moris626/rmap/arduino/doc/img/ethernet.jpg

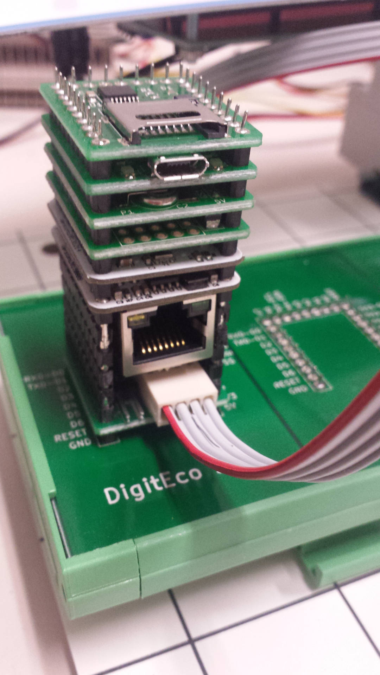
arduino/doc/img/ethernet.jpg
