moris626/rmap/arduino/doc/img/hub.jpg

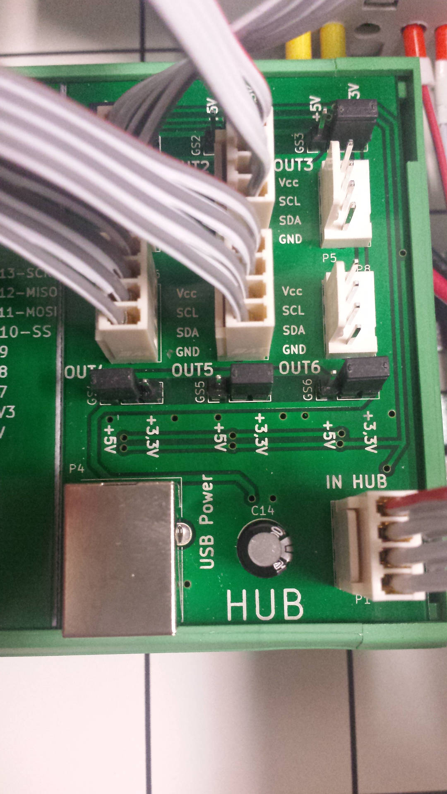
arduino/doc/img/hub.jpg
