moris626/rmap/kicad/r-map_v2/breakout_board/NO2-CO/README.md

Schematic preview
=================
