moris626/rmap/arduino/doc/img/gsm.jpg

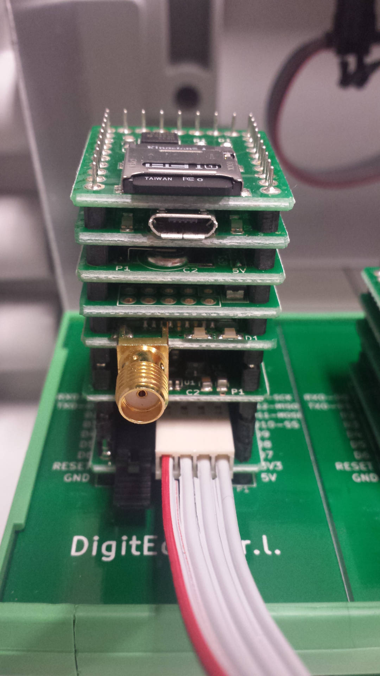
arduino/doc/img/gsm.jpg
