moris626/rmap/arduino/doc/img/passive.jpg

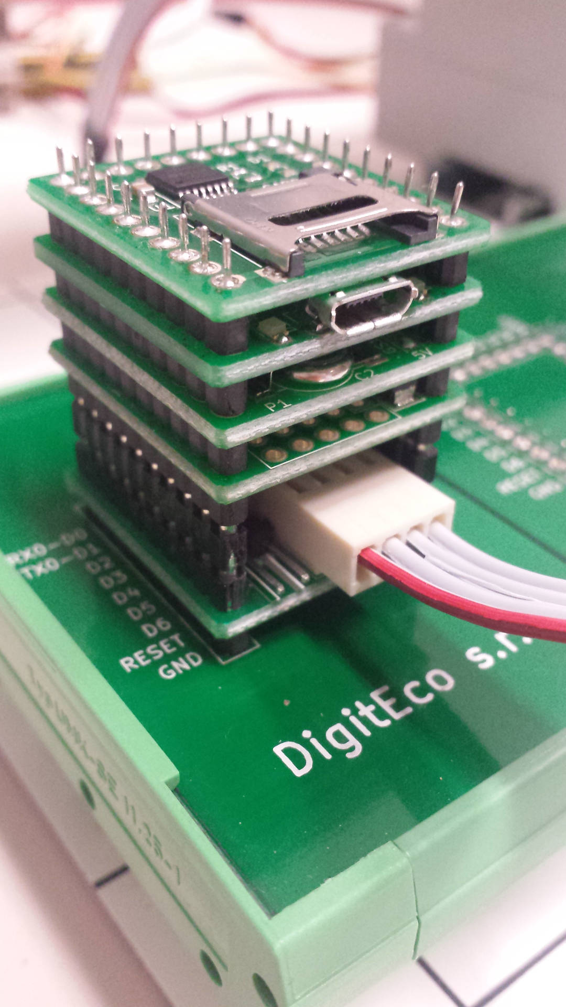
arduino/doc/img/passive.jpg
