moris626/rmap/arduino/doc/img/rain.jpg

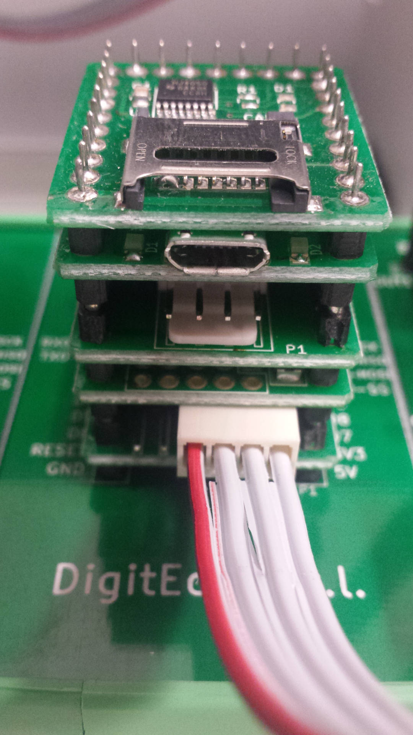
arduino/doc/img/rain.jpg
