moris626/rmap/arduino/doc/img/station.jpg

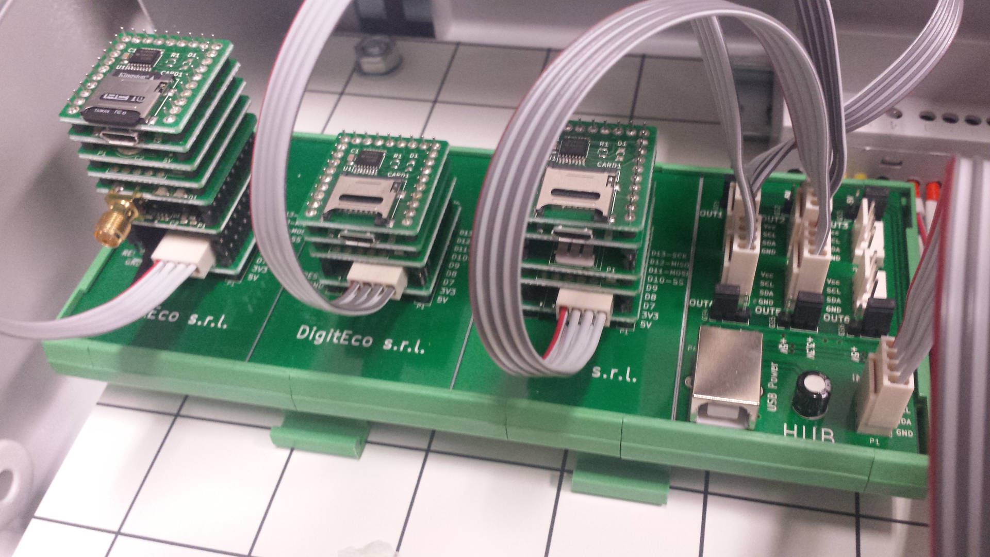
arduino/doc/img/station.jpg
