moris626/rmap/arduino/doc/img/th.jpg

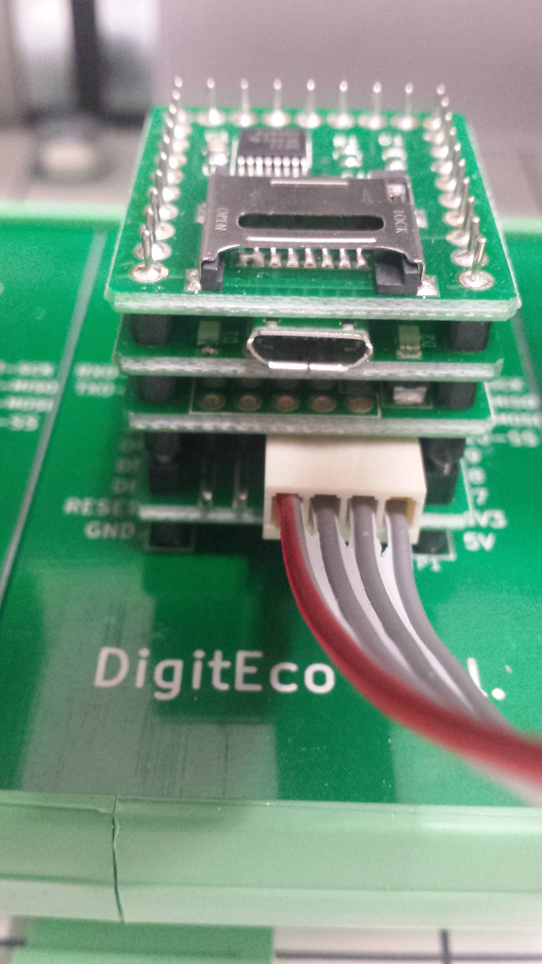
arduino/doc/img/th.jpg
