moris626/rmap/kicad/r-map_v2/Microduino_BASE_DE/Elenco_componenti_Base_DE.xls

Riferimento | Contenitore | QuantitÃ | Valore | Produttore
GS1 | GS3 | 1 | GS3
P1 | Pin_Header_Angled_1x02_Pitch2.54mm | 1 | CONN_01X02
P2 | AMPMODUII_4pin_90Â° | 1 | CONN_01X04
P3 | Upin_27 | 1 | CONN_1x27
