moris626/rmap/kicad/r-map_v2/Microduino_RTC_DE/Ordine_componenti_RTC_DE.xls

Riferimento | Contenitore | QuantitÃ | Valore | Produttore
C1 | C_0805 | 1 | 0,1 uF
C2 | Supercap | 1 | 0,2F
CV1 | C_1206 | 1 | 5-25 pF
D1 | D_MiniMELF_Standard | 1 | TMMBAT43
D2 | D_SOD-323 | 1 | MM3Z3V3ST1G
GS1,GS2,GS3 | GS3 | 3 | GS3
P1 | Strip femmina 1x27 Pitch2.54mm | 1 | CONN_01X27
R3,R1,R2 | R_0805 | 3 | 4k7
R4 | R_0805 | 1 | 33
U1 | SOIC-8_3.9x4.9mm_Pitch1.27mm | 1 | PCF8563
Y1 | Crystal_SMD_G8-2pin_3.2x1.5mm_HandSoldering | 1 | 32,762 kHz
