moris626/rmap/kicad/r-map_v2/Microduino_DIGITALE_DE/Ordine_componenti_DIGITALE_DE.xls

Riferimento | Contenitore | QuantitÃ | Valore | Produttore
P1 | Upin_27 | 1 | CONN_1x27
P2 | AMPMODUII_4pin_90Â° | 1 | CONN_01X04
