moris626/rmap/kicad/r-map_v2/Microduino_SUPPORTO_DE/Elenco_componenti_Supporto_DE.xls

Riferimento | Contenitore | QuantitÃ | Valore | Produttore
P1 | Upin_27 | 1 | CONN_1x27
