moris626/rmap/arduino/sketchbook/stima_v2/rmap_esp8266/HOWTO_en.md

With this firmware is possible to publish data on an RMAP server.
Short instructions:

    register on RMAP to get username and password:
    http://rmap.cc/registrazione/register/

    Make a new station on server:
    http://rmapv.rmap.cc/insertdata/newstation
    insert your address or use "draw a marker" instrument on map and insert the station name.
    Select "luftdaten" as station model type

Follow the standard procedure as for luftdaten.info for hardware hassembly.
http://luftdaten.info
but in the configuration page insert RMAP specifications:

    username
    password
    station name

Save and all is done.
