moris626/rmap/arduino/sketchbook/stima_v2/rmap_esp8266/HOWTO_it.md

Con questo firmware è possibile pubblicare i dati su un server RMAP.
Istruzioni in breve:

    registratevi sul server RMAP per ottenere username e password:
    http://rmap.cc/registrazione/register/

    Create una nuova stazione sul server:
    http://rmapv.rmap.cc/insertdata/newstation
    inserite il vostro indirizzo o utilizzate lo strumento "draw a marker" sulla mappa e inserite il nome della stazione.
    Selezionate "luftdaten" come modello della stazione

Seguite le istruzioni per assemblare l'hardware come descritto su luftdaten.info
http://luftdaten.info/it/traduzione-delle-istruzioni-per-il-montaggio-del-sensore-di-polveri-sottili/
ma nella pagina di configurazione inserite i dati per RMAP:

    username
    password
    nome stazione

Salvate e tutto è completato.
