moris626/rmap/kicad/stima_v3/Microduino_SD_DE/Microduino_SD_DE.kicad_pcb

## KiCad design kicad/stima_v3/Microduino_SD_DE/Microduino_SD_DE.kicad_pcb (2018-06-27)

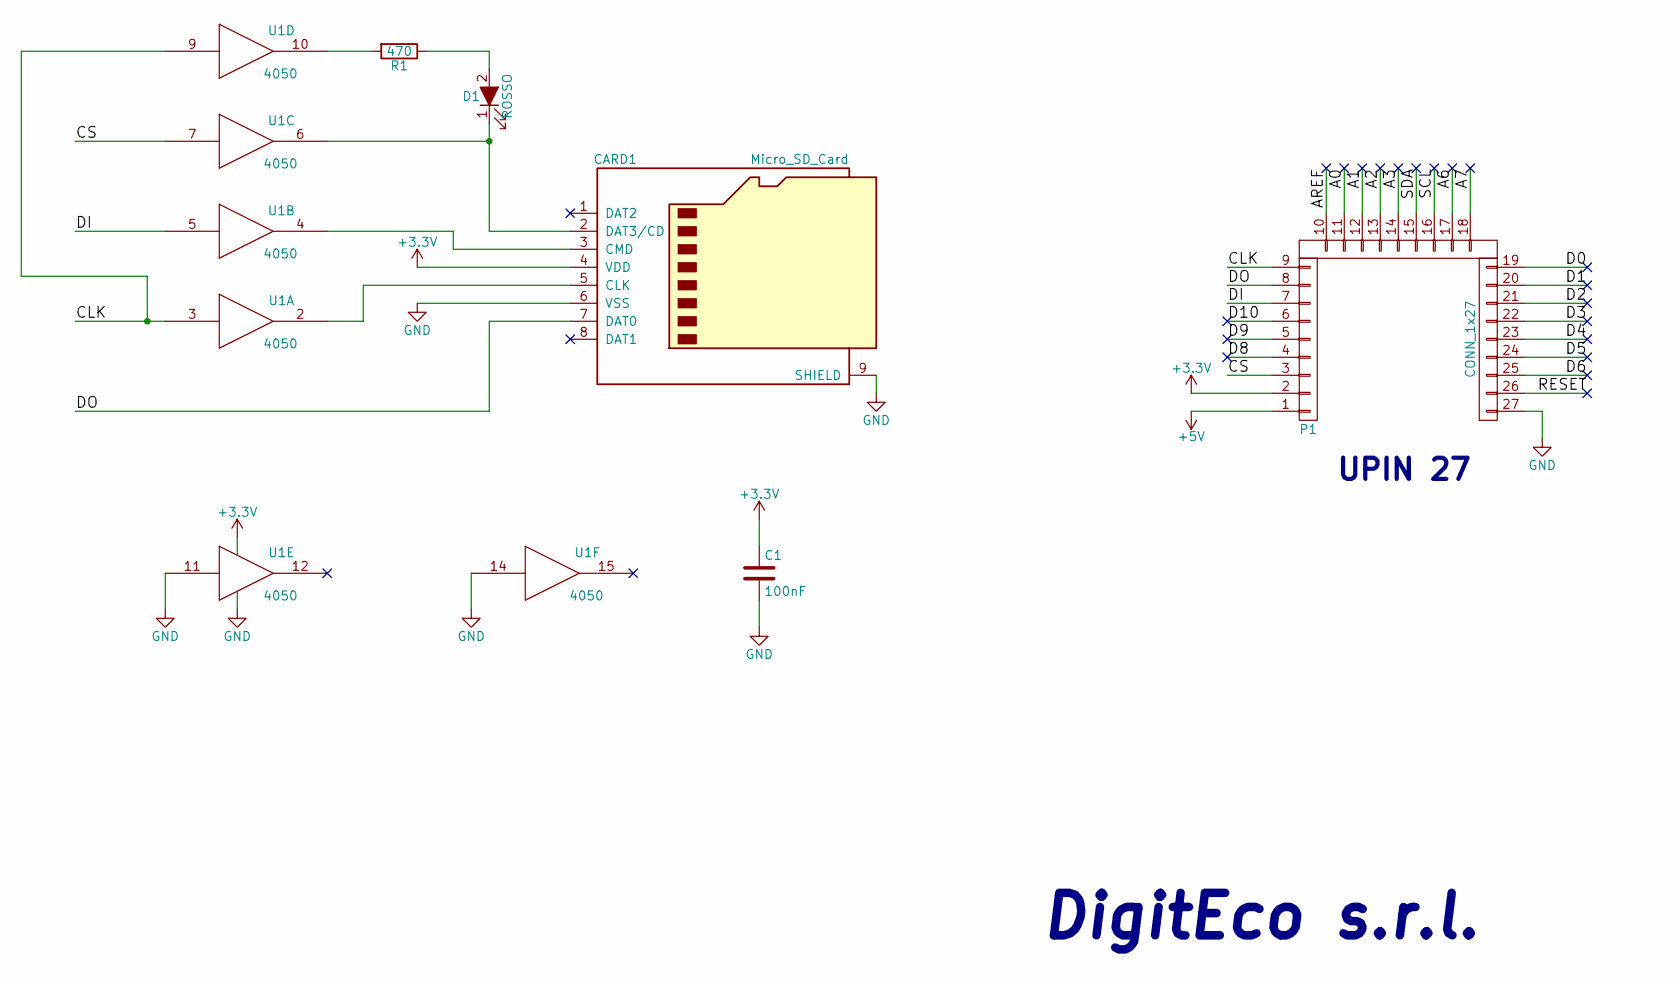
[picture p8: schematic Microduino_SD_DE.sch, Microduino SD DE]

Parts:
C1: 100nF; C_0805
CARD1: Micro_SD_Card; microSD_Card_Receptacle_Wuerth_693072010801
D1: ROSSO; LED_0805
P1: CONN_1x27; Upin_27
R1: 470; R_0805
U1: 4050; TSSOP-16_4.4x5mm_Pitch0.65mm

Connections:
+3V3: C1.1, CARD1.4 (VDD), P1.2, U1.1 (VCC)
+5V: P1.1
/A0: P1.11
/A1: P1.12
/A2: P1.13
/A3: P1.14
/A6: P1.17
/A7: P1.18
/AREF: P1.10
/CLK: P1.9, U1.3, U1.9
/CS: P1.3, U1.7
/D0: P1.19
/D1: P1.20
/D2: P1.21
/D3: P1.22
/D4: P1.23
/D5: P1.24
/D6: P1.25
/D8: P1.4
/D9: P1.5
/D10: P1.6
/DI: P1.7, U1.5
/DO: CARD1.7 (DAT0), P1.8
/RESET: P1.26
/SCL: P1.16
/SDA: P1.15
GND: C1.2, CARD1.6 (VSS), CARD1.9 (SHIELD), P1.27, U1.8 (VSS), U1.11, U1.14
unnamed: CARD1.2 (DAT3/CD), D1.1 (K), U1.6
unnamed: CARD1.3 (CMD), U1.4
unnamed: CARD1.5 (CLK), U1.2
unnamed: D1.2 (A), R1.1
unnamed: R1.2, U1.10

Notes on the sheet:
UPIN 27
DigitEco s.r.l.

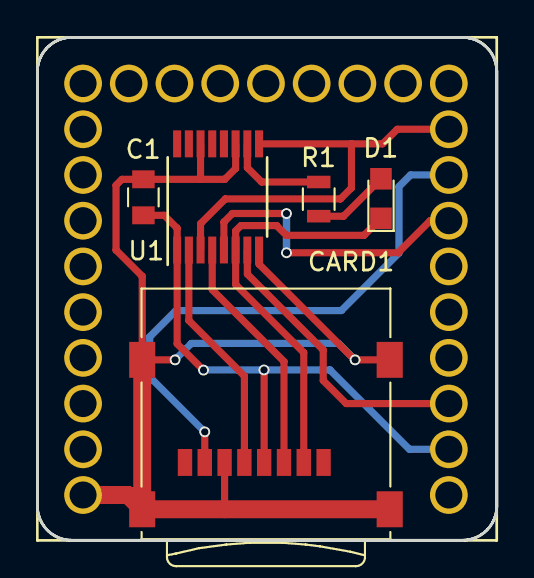
[picture p9: board Microduino_SD_DE.kicad_pcb from above]

Board: 2 copper layers, 25.5 x 27.9 mm, 6 parts (1 on the bottom side), 11 nets.
