moris626/rmap/kicad/stima_v3/Microduino_HUB_DE/Microduino_HUB_DE.kicad_pcb

## KiCad design kicad/stima_v3/Microduino_HUB_DE/Microduino_HUB_DE.kicad_pcb (2018-06-27)

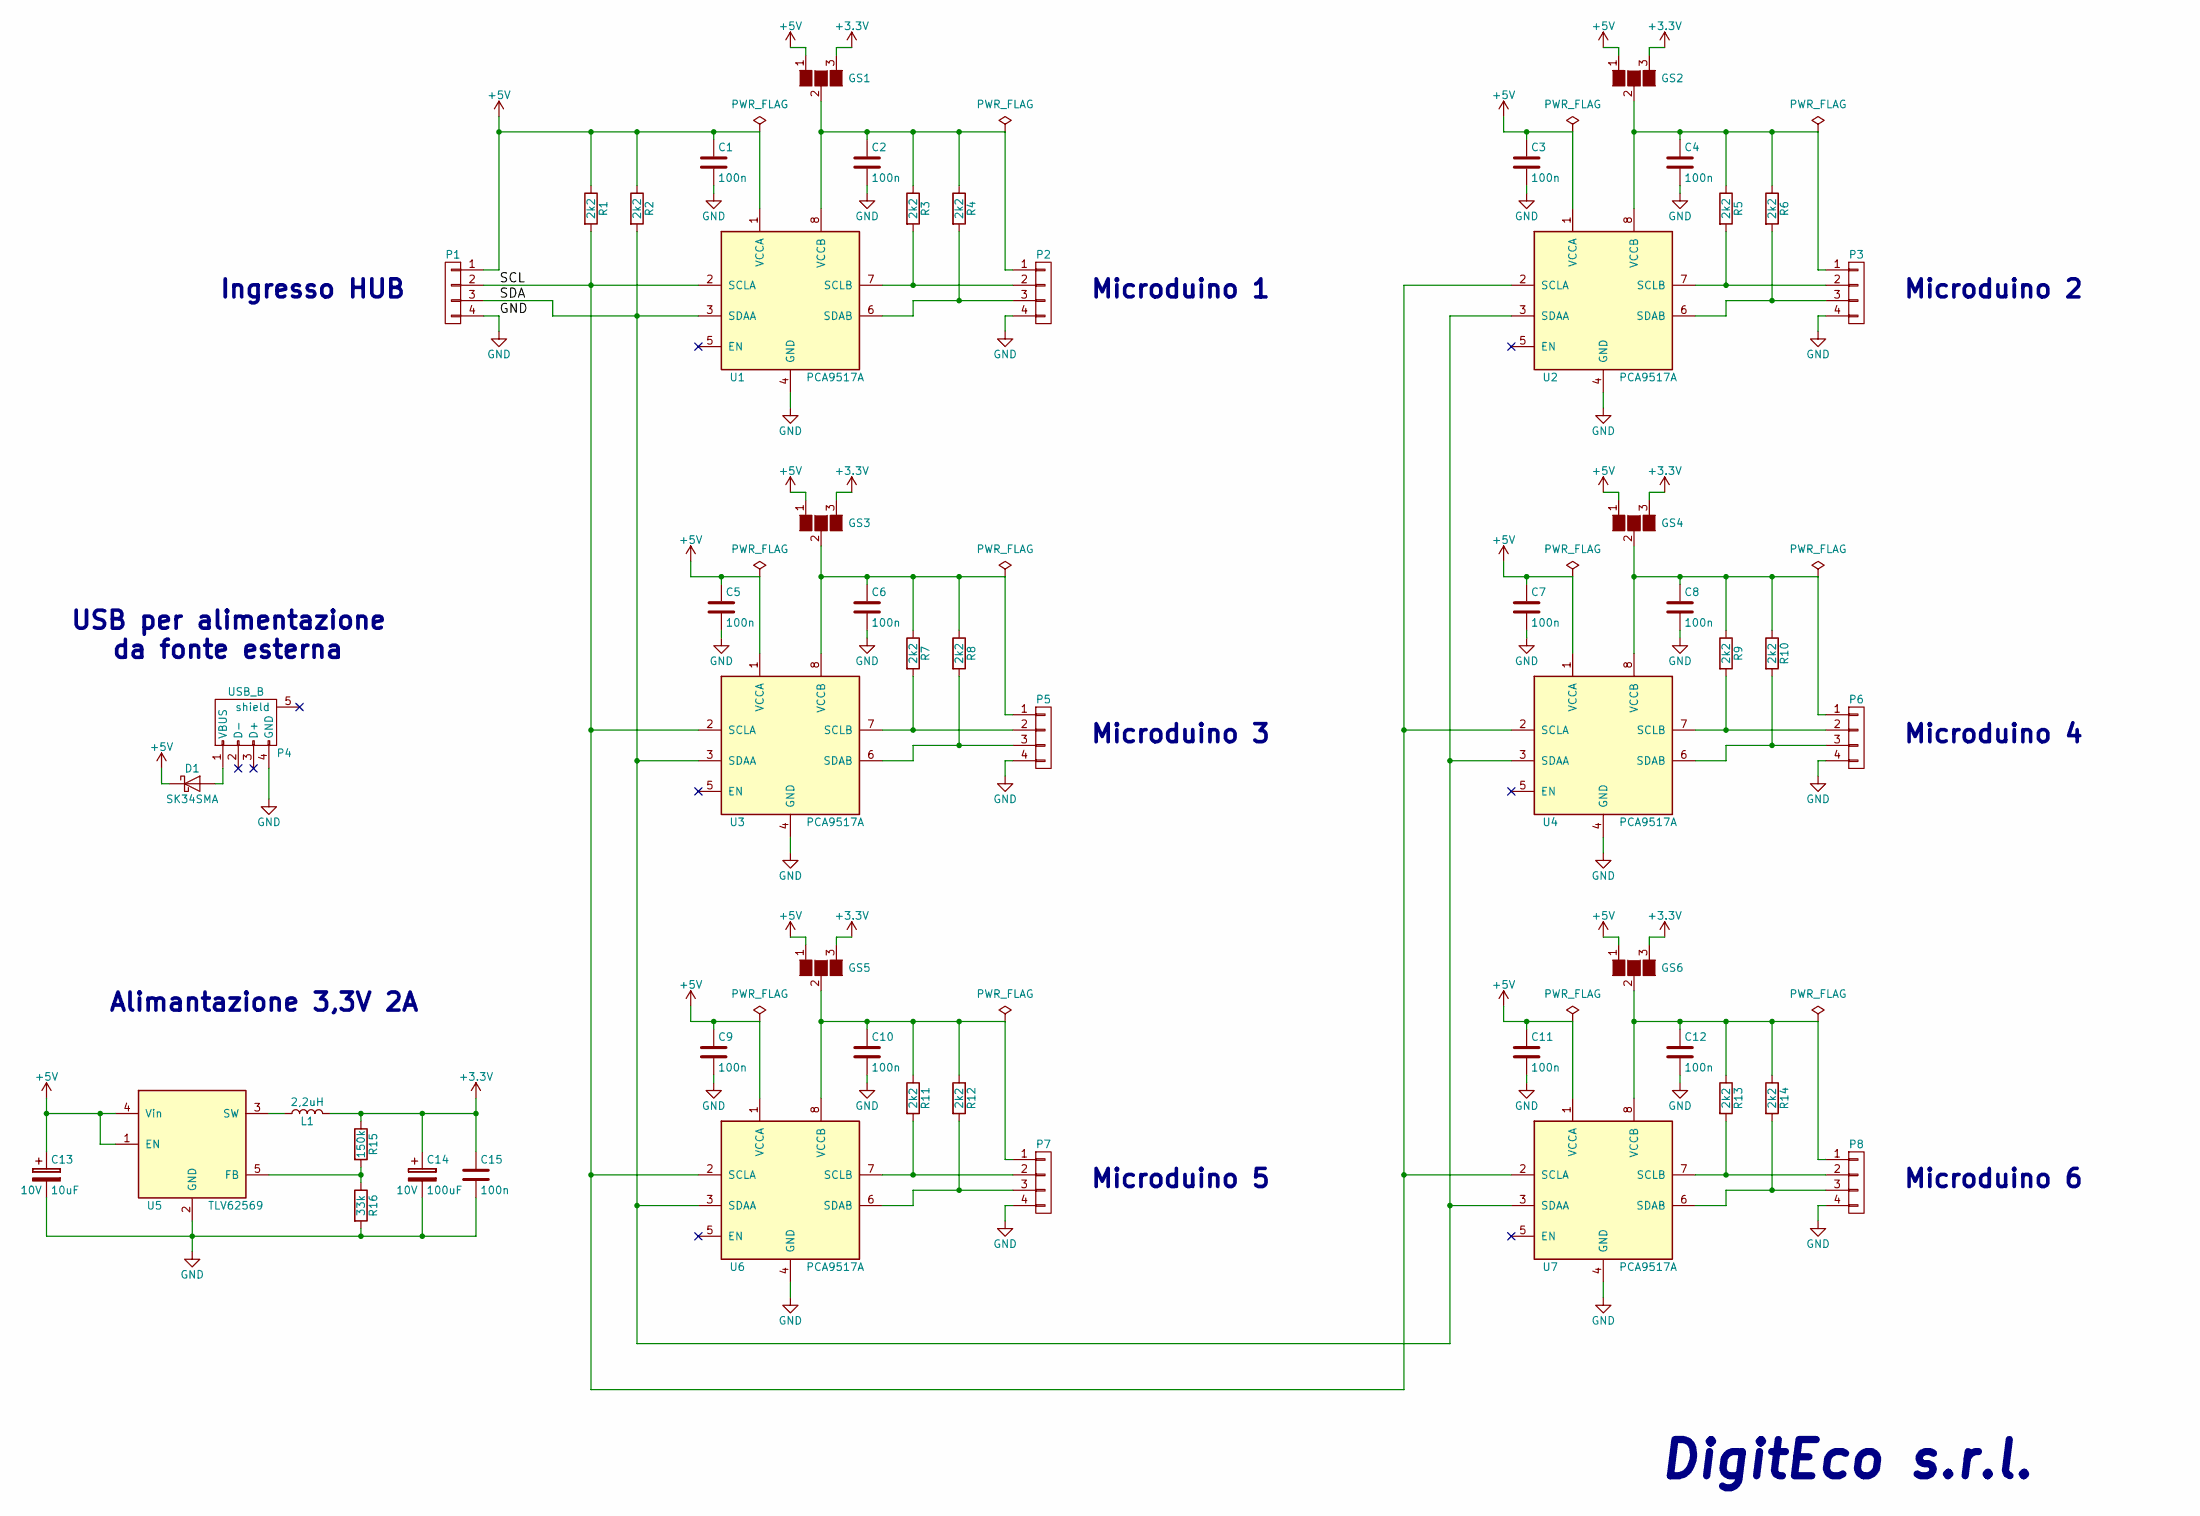
[picture p10: schematic Microduino_HUB_DE.sch, Microduino HUB DE]

Parts:
C1, C2, C3, C4, C5, C6, C7, C8, C9, C10, C11, C12, C15: 100n; C_1206
C13: 10uF; CP_Tantalum_Case-A_EIA-3216-18_Reflow
C14: 100uF; CP_Radial_D6.3mm_P2.50mm
D1: SK34SMA; D_SMA_Standard
GS1, GS2, GS3, GS4, GS5, GS6: GS3; Pin_Header_Straight_1x03_Pitch2.54mm
L1: 2,2uH; Induttanza_SMD_2520_Wurth
P1, P2, P3, P5, P6, P7, P8: CONN_01X04; WURTH_4pin_straight_61900411121
P4: USB_B
R1, R2, R3, R4, R5, R6, R7, R8, R9, R10, R11, R12, R13, R14: 2k2; R_1206
R15: 150k; R_1206
R16: 33k; R_1206
U1, U2, U3, U4, U6, U7: PCA9517A; SOIC-8_3.9x4.9mm_Pitch1.27mm
U5: TLV62569; SOT-23-5

Connections:
+3V3: C14.1, C15.1, GS1.3 (G3), GS2.3 (G3), GS3.3 (G3), GS4.3 (G3), GS5.3 (G3), GS6.3 (G3), L1.2, R15.1
+5V: C1.1, C3.1, C5.1, C7.1, C9.1, C11.1, C13.1, D1.1 (K), GS1.1 (G1), GS2.1 (G1), GS3.1 (G1), GS4.1 (G1), GS5.1 (G1), GS6.1 (G1), P1.1, R1.1, R2.1, U1.1 (VCCA), U2.1 (VCCA), U3.1 (VCCA), U4.1 (VCCA), U5.1 (EN), U5.4 (Vin), U6.1 (VCCA), U7.1 (VCCA)
/SCL: P1.2, R1.2, U1.2 (SCLA), U2.2 (SCLA), U3.2 (SCLA), U4.2 (SCLA), U6.2 (SCLA), U7.2 (SCLA)
/SDA: P1.3, R2.2, U1.3 (SDAA), U2.3 (SDAA), U3.3 (SDAA), U4.3 (SDAA), U6.3 (SDAA), U7.3 (SDAA)
GND: C1.2, C2.2, C3.2, C4.2, C5.2, C6.2, C7.2, C8.2, C9.2, C10.2, C11.2, C12.2, C13.2, C14.2, C15.2, P1.4, P2.4, P3.4, P4.4 (GND), P5.4, P6.4, P7.4, P8.4, R16.2, U1.4 (GND), U2.4 (GND), U3.4 (GND), U4.4 (GND), U5.2 (GND), U6.4 (GND), U7.4 (GND)
unnamed: C2.1, GS1.2 (G2), P2.1, R3.1, R4.1, U1.8 (VCCB)
unnamed: C4.1, GS2.2 (G2), P3.1, R5.1, R6.1, U2.8 (VCCB)
unnamed: C6.1, GS3.2 (G2), P5.1, R7.1, R8.1, U3.8 (VCCB)
unnamed: C8.1, GS4.2 (G2), P6.1, R9.1, R10.1, U4.8 (VCCB)
unnamed: C10.1, GS5.2 (G2), P7.1, R11.1, R12.1, U6.8 (VCCB)
unnamed: C12.1, GS6.2 (G2), P8.1, R13.1, R14.1, U7.8 (VCCB)
unnamed: D1.2 (A), P4.1 (VBUS)
unnamed: L1.1, U5.3 (SW)
unnamed: P2.2, R3.2, U1.7 (SCLB)
unnamed: P2.3, R4.2, U1.6 (SDAB)
unnamed: P3.2, R5.2, U2.7 (SCLB)
unnamed: P3.3, R6.2, U2.6 (SDAB)
unnamed: P5.2, R7.2, U3.7 (SCLB)
unnamed: P5.3, R8.2, U3.6 (SDAB)
unnamed: P6.2, R9.2, U4.7 (SCLB)
unnamed: P6.3, R10.2, U4.6 (SDAB)
unnamed: P7.2, R11.2, U6.7 (SCLB)
unnamed: P7.3, R12.2, U6.6 (SDAB)
unnamed: P8.2, R13.2, U7.7 (SCLB)
unnamed: P8.3, R14.2, U7.6 (SDAB)
unnamed: R15.2, R16.1, U5.5 (FB)

Notes on the sheet:
DigitEco s.r.l.
Microduino 1
Microduino 3
Microduino 5
Microduino 2
Microduino 4
Microduino 6
Ingresso HUB
USB per alimentazione da fonte esterna
Alimantazione 3,3V 2A

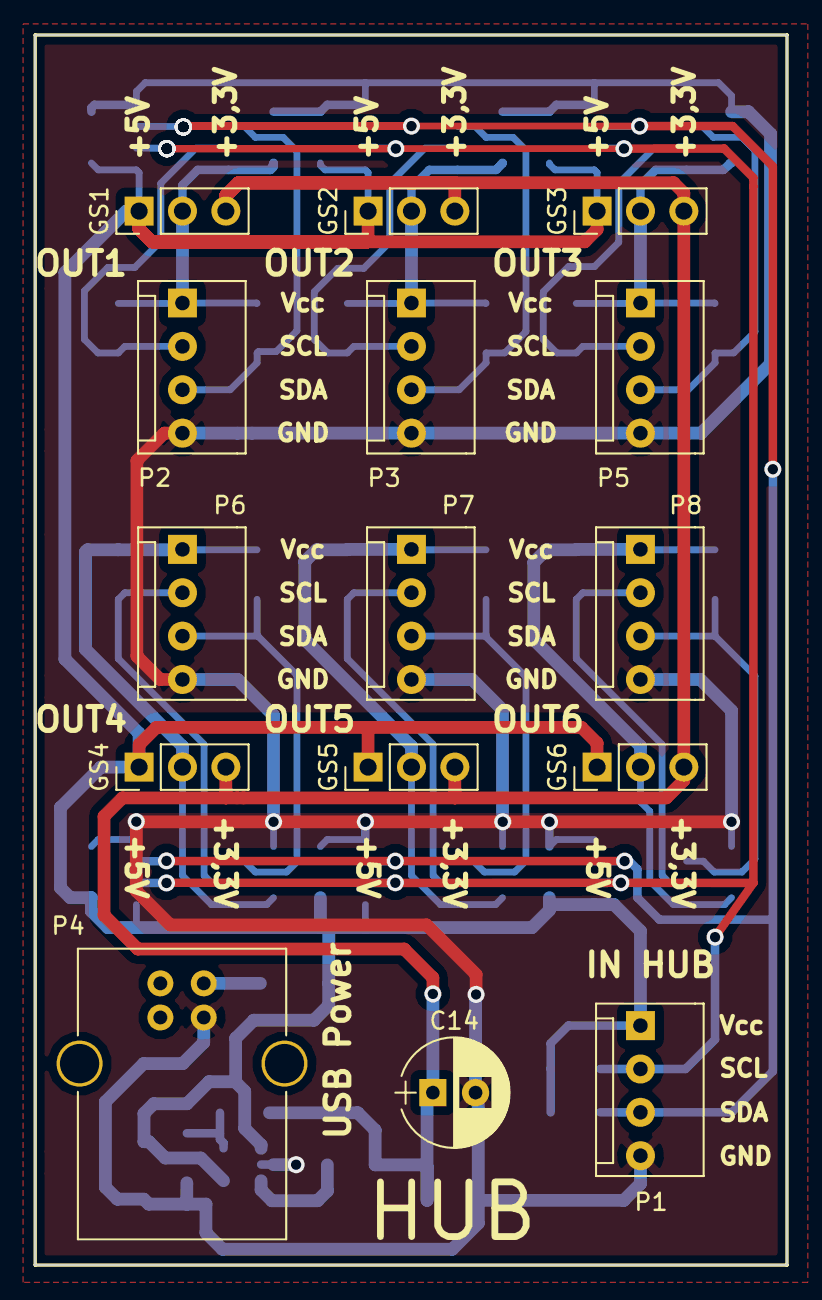
[picture p11: board Microduino_HUB_DE.kicad_pcb from above]

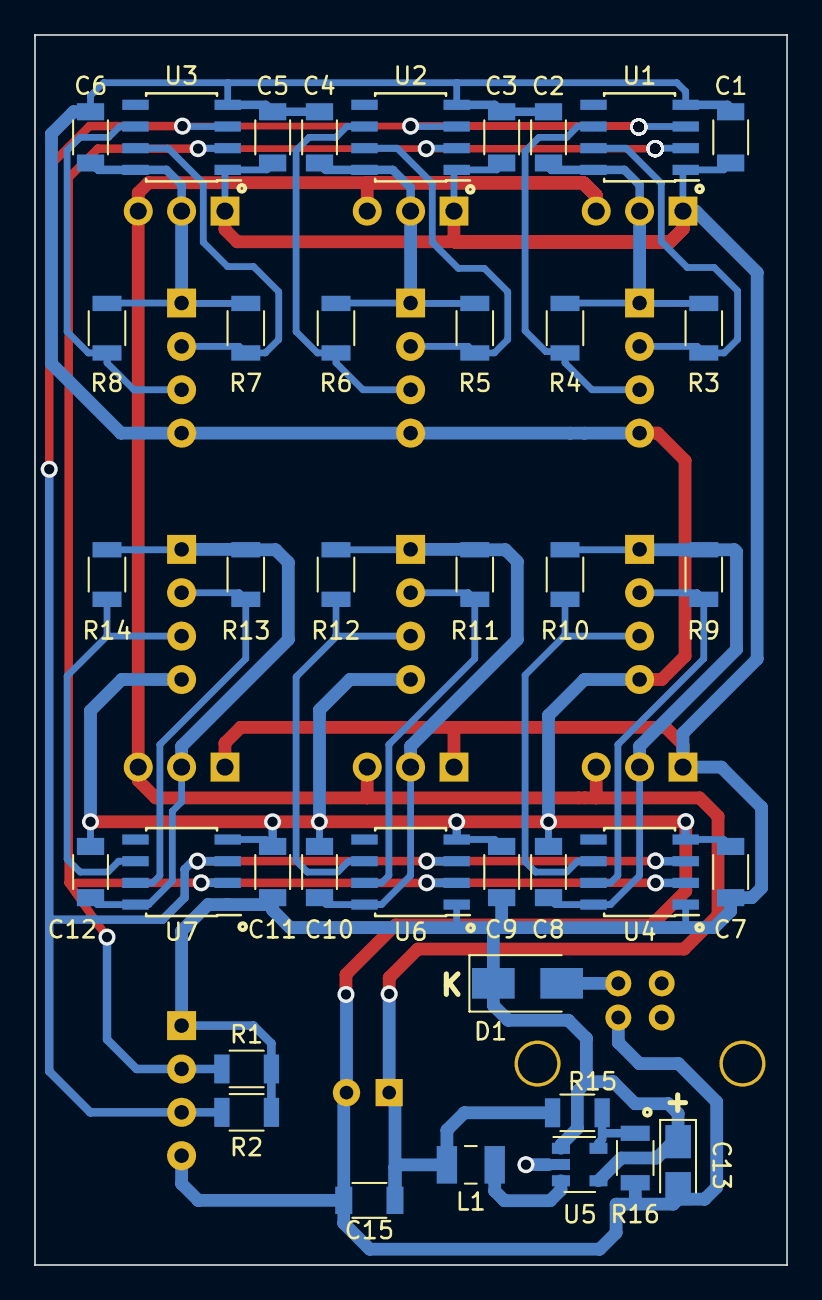
[picture p12: board Microduino_HUB_DE.kicad_pcb from below]

Board: 2 copper layers, 44.0 x 72.0 mm, 54 parts (39 on the bottom side), 26 nets.
