moris626/rmap/kicad/stima_v3/Microduino_FT232R_DE/Microduino_FT232R_DE.kicad_pcb

## KiCad design kicad/stima_v3/Microduino_FT232R_DE/Microduino_FT232R_DE.kicad_pcb (2018-06-27)

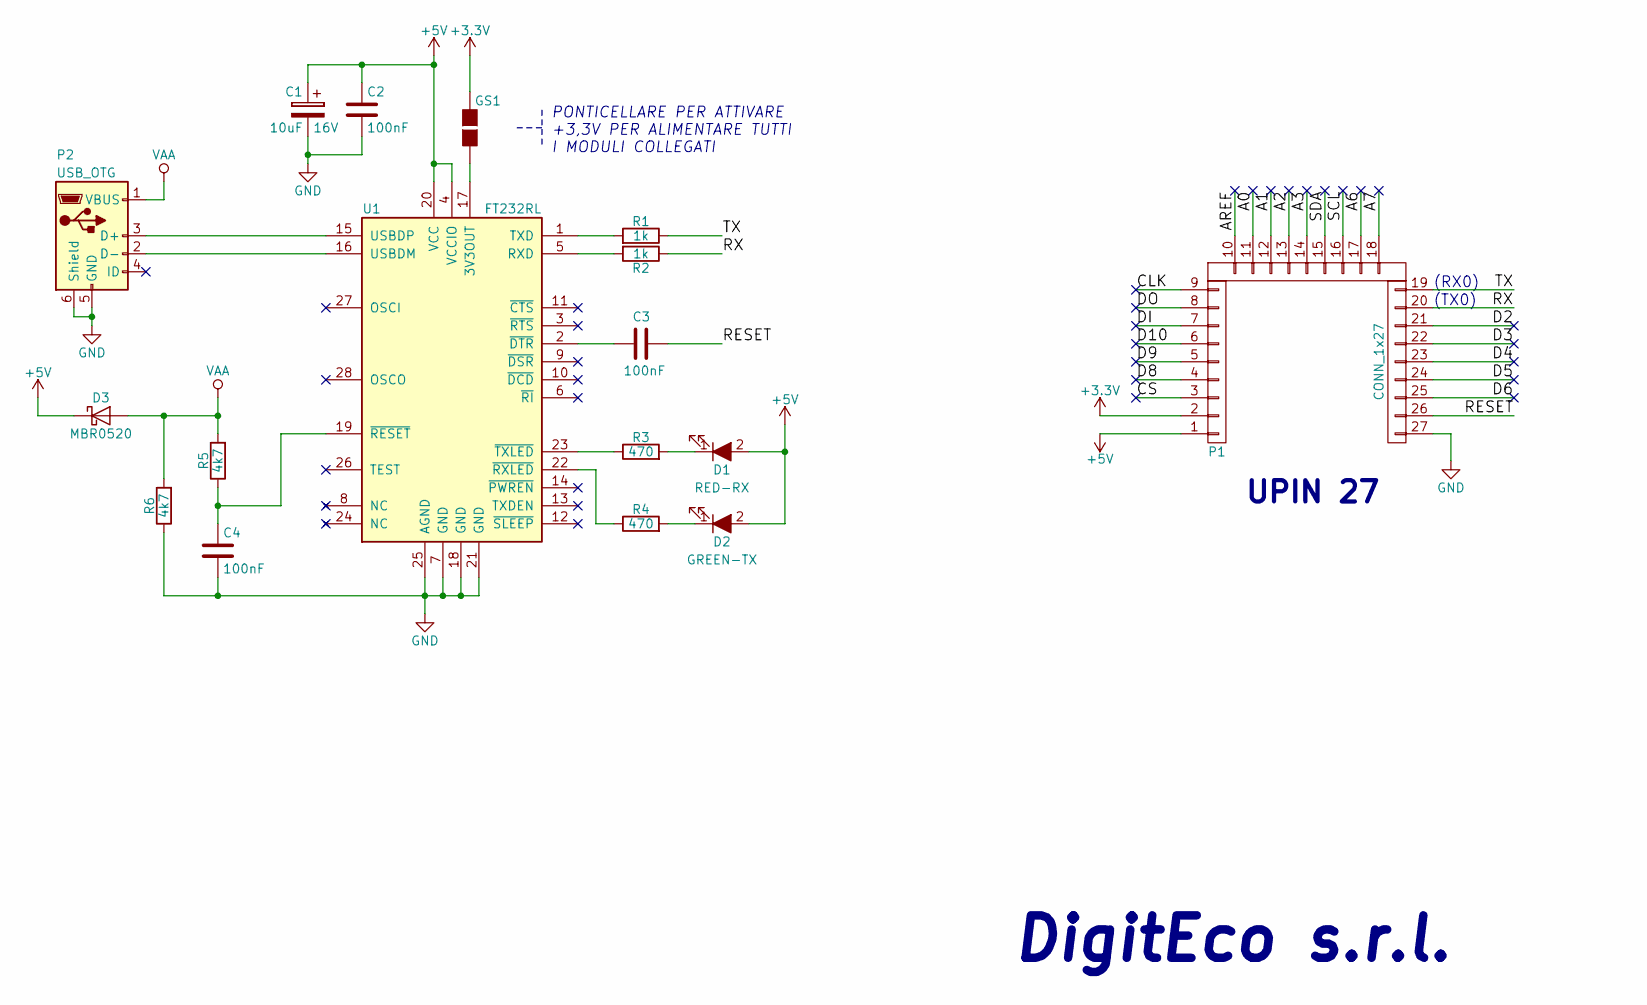
[picture p13: schematic Microduino_FT232R_DE.sch, Microduino FT232R DE]

Parts:
C1: 10uF; SMD-1210_Pol
C2, C3, C4: 100nF; C_0805
D1: RED-RX; LED_0805
D2: GREEN-TX; LED_0805
D3: MBR0520; D_SOD-123
GS1: GS2
P1: CONN_1x27; Upin_27
P2: USB_OTG; USB_Micro-B_Molex-105017-0001
R1, R2: 1k; R_0805
R3, R4: 470; R_0805
R5, R6: 4k7; R_0805
U1: FT232RL; SSOP-28_5.3x10.2mm_Pitch0.65mm

Connections:
+3V3: GS1.1 (G1), P1.2
+5V: C1.1, C2.1, D1.2 (A), D2.2 (A), D3.1 (K), P1.1, U1.4 (VCCIO), U1.20 (VCC)
/A0: P1.11
/A1: P1.12
/A2: P1.13
/A3: P1.14
/A6: P1.17
/A7: P1.18
/AREF: P1.10
/CLK: P1.9
/CS: P1.3
/D2: P1.21
/D3: P1.22
/D4: P1.23
/D5: P1.24
/D6: P1.25
/D8: P1.4
/D9: P1.5
/D10: P1.6
/DI: P1.7
/DO: P1.8
/RESET: C3.1, P1.26
/RX: P1.20, R2.1
/SCL: P1.16
/SDA: P1.15
/TX: P1.19, R1.1
GND: C1.2, C2.2, C4.2, P1.27, P2.5 (GND), P2.6 (Shield), R6.1, U1.7 (GND), U1.18 (GND), U1.21 (GND), U1.25 (AGND)
unnamed: C3.2, U1.2 (~DTR)
unnamed: C4.1, R5.1, U1.19 (~RESET)
unnamed: D1.1 (K), R3.2
unnamed: D2.1 (K), R4.2
unnamed: GS1.2 (G2), U1.17 (3V3OUT)
unnamed: P2.2 (D-), U1.16 (USBDM)
unnamed: P2.3 (D+), U1.15 (USBDP)
unnamed: R1.2, U1.1 (TXD)
unnamed: R2.2, U1.5 (RXD)
unnamed: R3.1, U1.23 (~TXLED)
unnamed: R4.1, U1.22 (~RXLED)
VAA: D3.2 (A), P2.1 (VBUS), R5.2, R6.2

Notes on the sheet:
UPIN 27
DigitEco s.r.l.
(RX0)
(TX0)
PONTICELLARE PER ATTIVARE +3,3V PER ALIMENTARE TUTTI I MODULI COLLEGATI

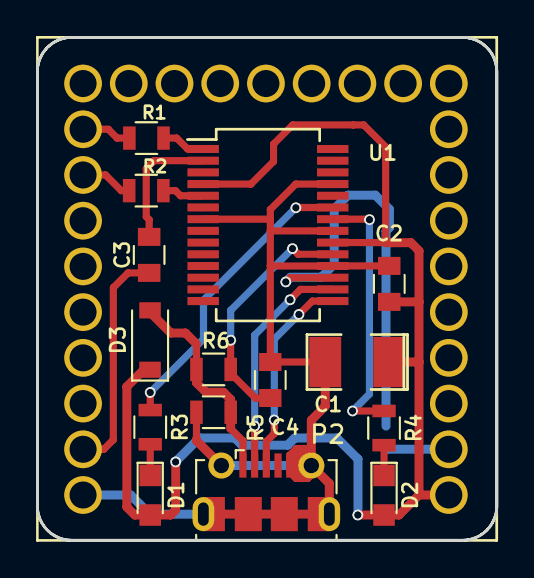
[picture p14: board Microduino_FT232R_DE.kicad_pcb from above]

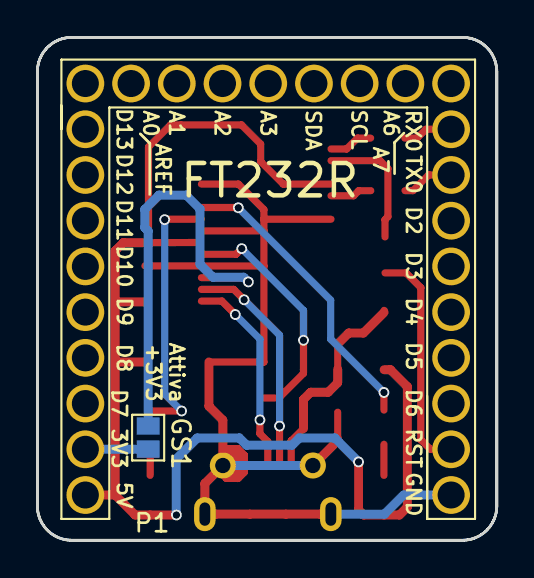
[picture p15: board Microduino_FT232R_DE.kicad_pcb from below]

Board: 2 copper layers, 25.5 x 27.9 mm, 17 parts (2 on the bottom side), 18 nets.
