moris626/rmap/kicad/stima_v3/Microduino_Core+_DE/Microduino_Core+_DE.kicad_pcb

## KiCad design kicad/stima_v3/Microduino_Core+_DE/Microduino_Core+_DE.kicad_pcb (2018-06-27)

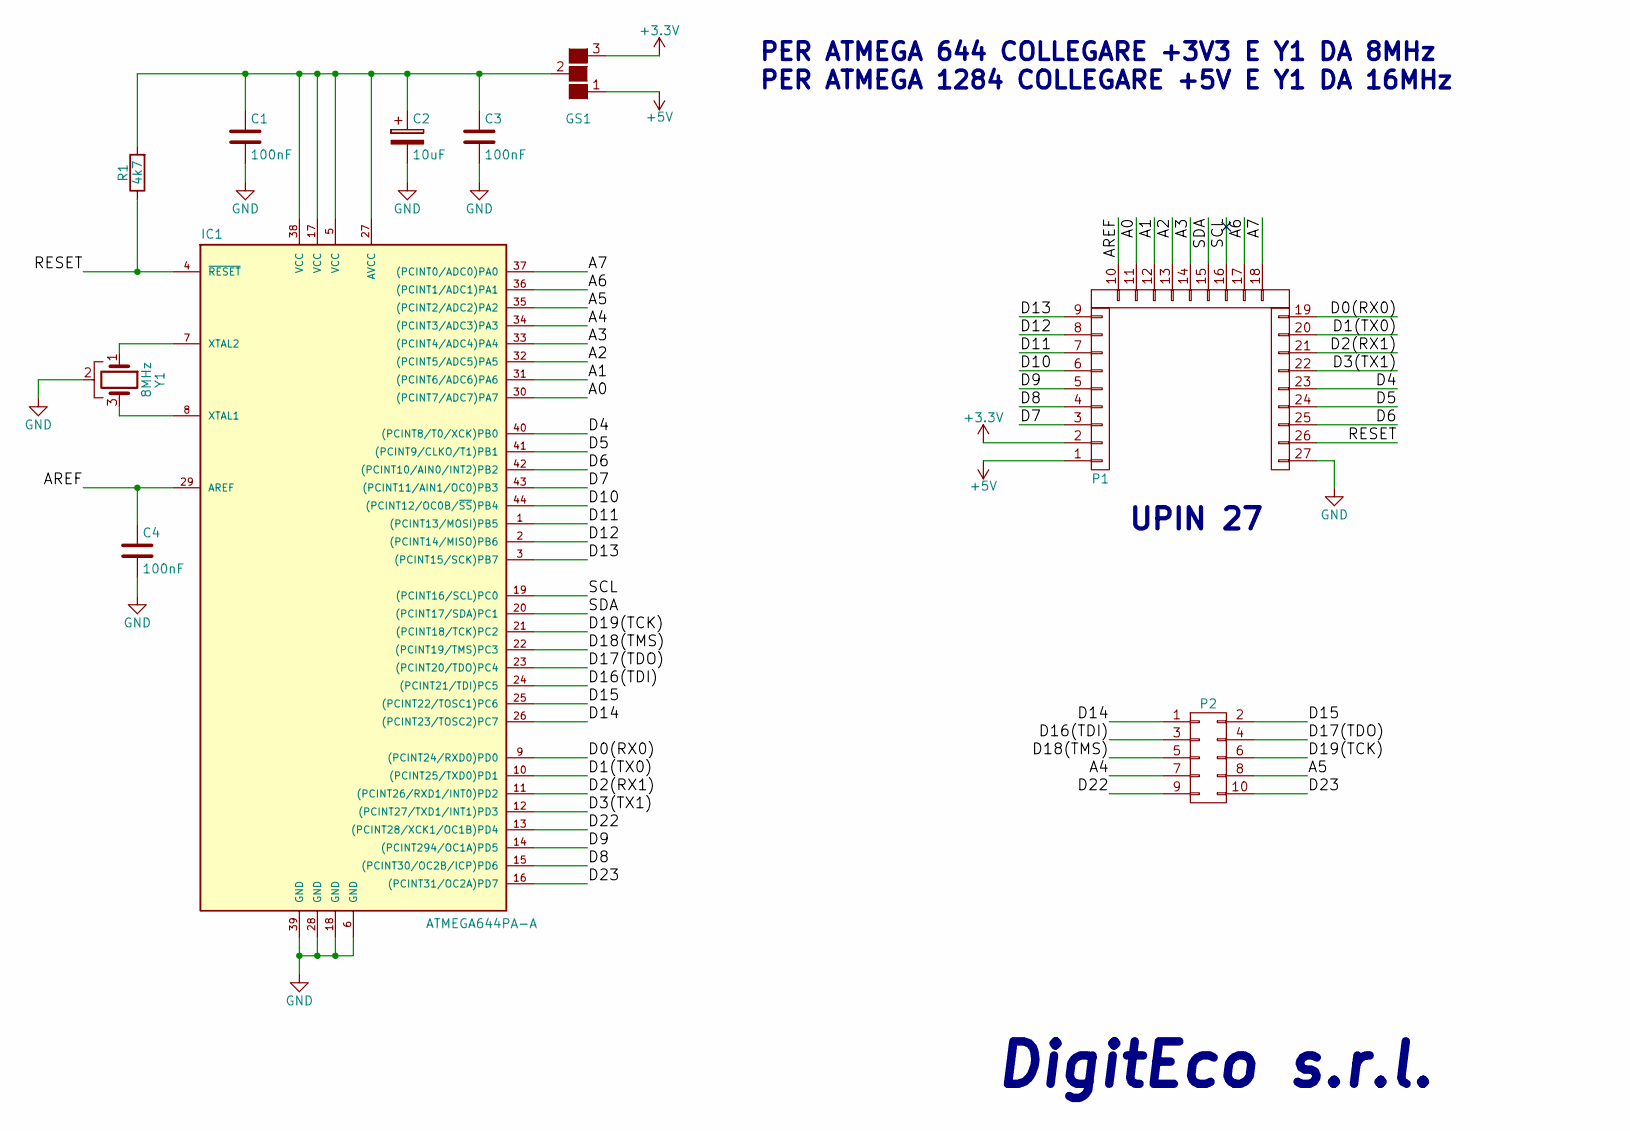
[picture p16: schematic Microduino_Core+_DE.sch, Microduino Core+ DE]

Parts:
C1: 100nF; C_0805_315°
C2: 10uF; CP_Tantalum_Case-B_EIA-3528-21_Reflow
C3, C4: 100nF; C_0805
GS1: GS3
IC1: ATMEGA644PA-A; TQFP-44_10x10mm_Pitch0.8mm
P1: CONN_1x27; Upin_27
P2: CONN_02X05; Pin_Header_Straight_2x05_Pitch2.54mm
R1: 4k7; R_0805
Y1: 8MHz; Resonator_SMD_muRata_CST-3pin_3.2x1.3mm

Connections:
+3V3: GS1.3 (G3), P1.2
+5V: GS1.1 (G1), P1.1
/A0: IC1.30 ((PCINT7/ADC7)PA7), P1.11
/A1: IC1.31 ((PCINT6/ADC6)PA6), P1.12
/A2: IC1.32 ((PCINT5/ADC5)PA5), P1.13
/A3: IC1.33 ((PCINT4/ADC4)PA4), P1.14
/A4: IC1.34 ((PCINT3/ADC3)PA3), P2.7
/A5: IC1.35 ((PCINT2/ADC2)PA2), P2.8
/A6: IC1.36 ((PCINT1/ADC1)PA1), P1.17
/A7: IC1.37 ((PCINT0/ADC0)PA0), P1.18
/AREF: C4.1, IC1.29 (AREF), P1.10
/D0(RX0): IC1.9 ((PCINT24/RXD0)PD0), P1.19
/D1(TX0): IC1.10 ((PCINT25/TXD0)PD1), P1.20
/D2(RX1): IC1.11 ((PCINT26/RXD1/INT0)PD2), P1.21
/D3(TX1): IC1.12 ((PCINT27/TXD1/INT1)PD3), P1.22
/D4: IC1.40 ((PCINT8/T0/XCK)PB0), P1.23
/D5: IC1.41 ((PCINT9/CLKO/T1)PB1), P1.24
/D6: IC1.42 ((PCINT10/AIN0/INT2)PB2), P1.25
/D7: IC1.43 ((PCINT11/AIN1/OC0)PB3), P1.3
/D8: IC1.15 ((PCINT30/OC2B/ICP)PD6), P1.4
/D9: IC1.14 ((PCINT294/OC1A)PD5), P1.5
/D10: IC1.44 ((PCINT12/OC0B/~SS~)PB4), P1.6
/D11: IC1.1 ((PCINT13/MOSI)PB5), P1.7
/D12: IC1.2 ((PCINT14/MISO)PB6), P1.8
/D13: IC1.3 ((PCINT15/SCK)PB7), P1.9
/D14: IC1.26 ((PCINT23/TOSC2)PC7), P2.1
/D15: IC1.25 ((PCINT22/TOSC1)PC6), P2.2
/D16(TDI): IC1.24 ((PCINT21/TDI)PC5), P2.3
/D17(TDO): IC1.23 ((PCINT20/TDO)PC4), P2.4
/D18(TMS): IC1.22 ((PCINT19/TMS)PC3), P2.5
/D19(TCK): IC1.21 ((PCINT18/TCK)PC2), P2.6
/D22: IC1.13 ((PCINT28/XCK1/OC1B)PD4), P2.9
/D23: IC1.16 ((PCINT31/OC2A)PD7), P2.10
/RESET: IC1.4 (~RESET), P1.26, R1.1
/SCL: IC1.19 ((PCINT16/SCL)PC0), P1.16
/SDA: IC1.20 ((PCINT17/SDA)PC1), P1.15
GND: C1.2, C2.2, C3.2, C4.2, IC1.6 (GND), IC1.18 (GND), IC1.28 (GND), IC1.39 (GND), P1.27, Y1.2
unnamed: C1.1, C2.1, C3.1, GS1.2 (G2), IC1.5 (VCC), IC1.17 (VCC), IC1.27 (AVCC), IC1.38 (VCC), R1.2
unnamed: IC1.7 (XTAL2), Y1.1
unnamed: IC1.8 (XTAL1), Y1.3

Notes on the sheet:
UPIN 27
DigitEco s.r.l.
PER ATMEGA 644 COLLEGARE +3V3 E Y1 DA 8MHz PER ATMEGA 1284 COLLEGARE +5V E Y1 DA 16MHz

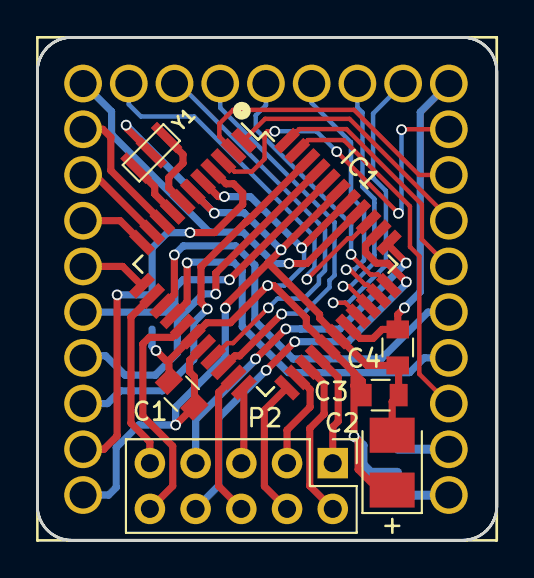
[picture p17: board Microduino_Core+_DE.kicad_pcb from above]

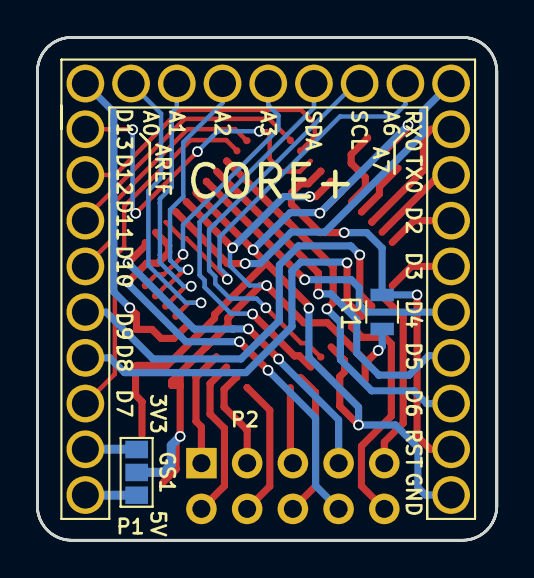
[picture p18: board Microduino_Core+_DE.kicad_pcb from below]

Board: 2 copper layers, 25.5 x 27.9 mm, 10 parts (3 on the bottom side), 40 nets.
