moris626/rmap/kicad/stima_v3/Microduino_GSM_DE/SIM_shield_DE/Microduino_SIM_shield_DE.kicad_pcb

## KiCad design kicad/stima_v3/Microduino_GSM_DE/SIM_shield_DE/Microduino_SIM_shield_DE.kicad_pcb (2018-06-27)

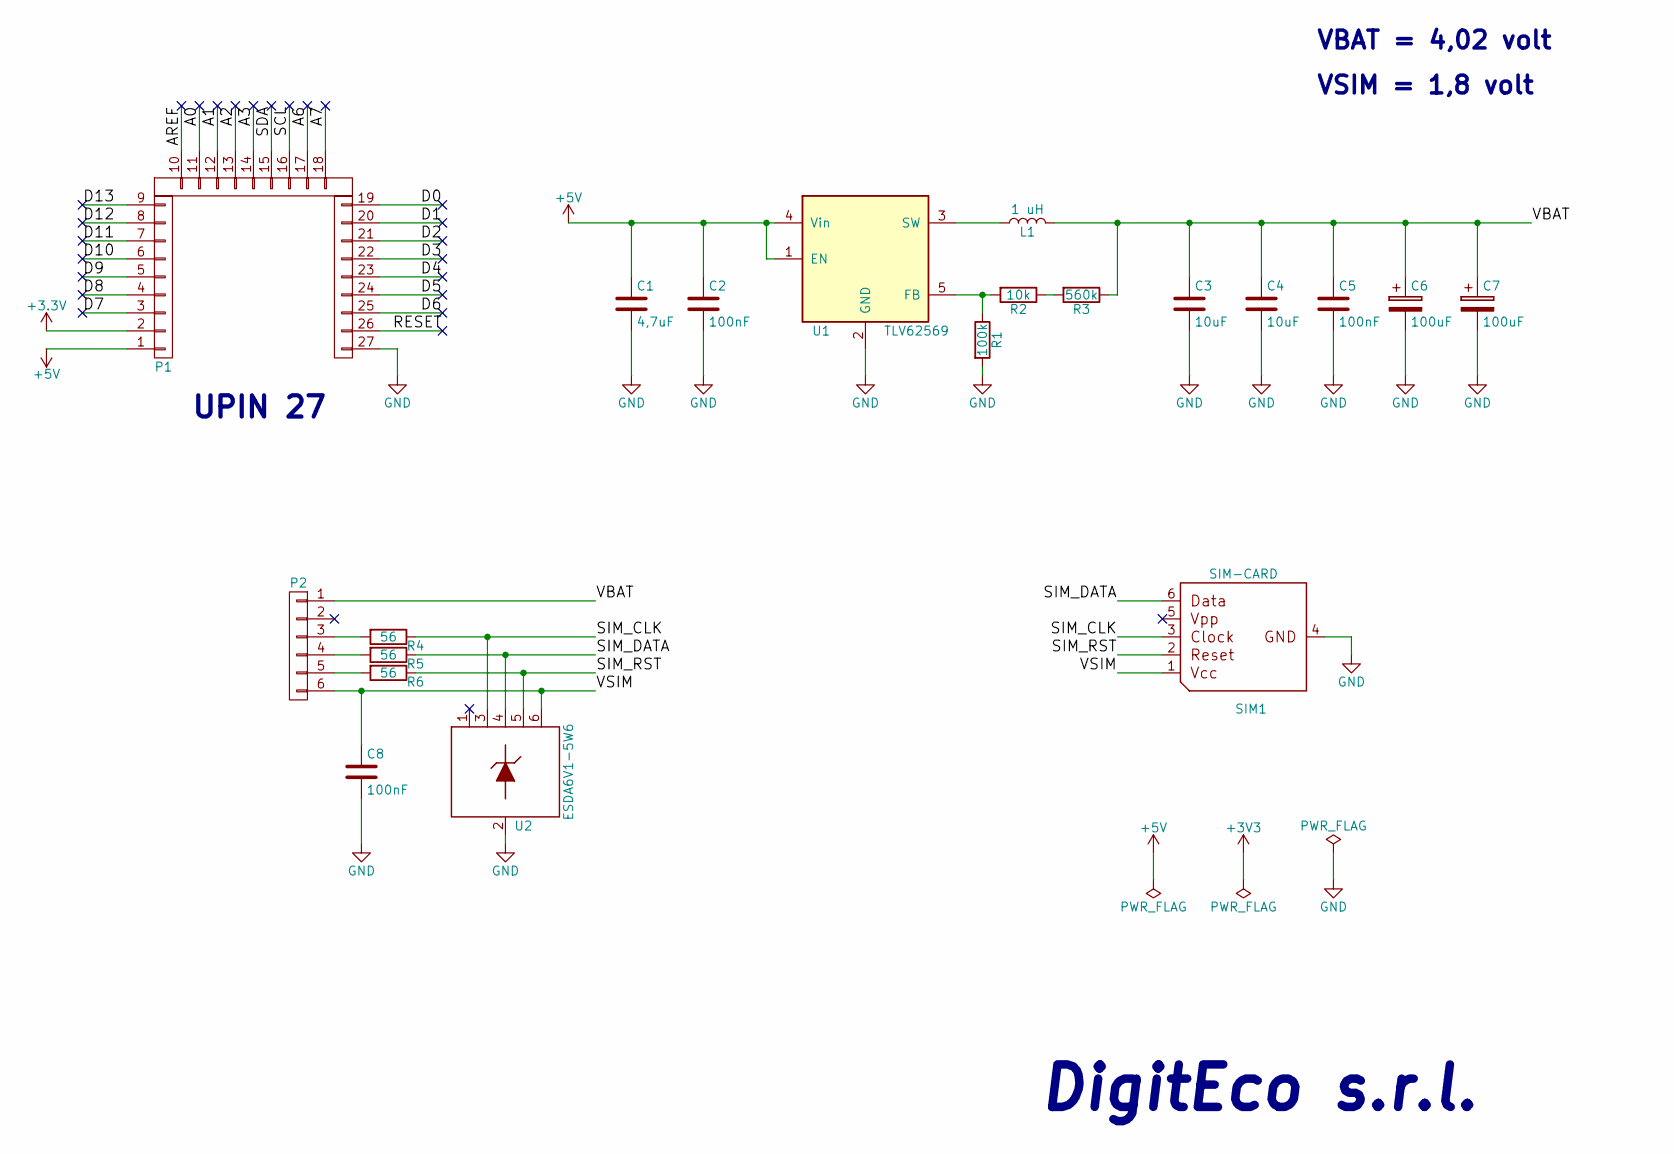
[picture p19: schematic Microduino_SIM_shield_DE.sch, Microduino SIM shield DE]

Parts:
C1: 4,7uF; C_0805
C2, C5, C8: 100nF; C_0805
C3, C4: 10uF; C_0805
C6, C7: 100uF; CP_Tantalum_Case-B_EIA-3528-21_Reflow
L1: 1 uH; Induttanza_SMD_3030_Vishay
P1: CONN_1x27; Upin_27
P2: CONN_01X06; Pin_Header_Straight_1x06_Pitch2.54mm
R1: 100k; R_0805
R2: 10k; R_0805
R3: 560k; R_0805
R4, R5, R6: 56; R_0805
SIM1: SIM-CARD; mini_sim_card_holder
U1: TLV62569; SOT-23-5
U2: ESDA6V1-5W6; SOT-363_SC-70-6

Connections:
+3V3: P1.2
+5V: C1.1, C2.1, P1.1, U1.1 (EN), U1.4 (Vin)
/A0: P1.11
/A1: P1.12
/A2: P1.13
/A3: P1.14
/A6: P1.17
/A7: P1.18
/AREF: P1.10
/D0: P1.19
/D1: P1.20
/D2: P1.21
/D3: P1.22
/D4: P1.23
/D5: P1.24
/D6: P1.25
/D7: P1.3
/D8: P1.4
/D9: P1.5
/D10: P1.6
/D11: P1.7
/D12: P1.8
/D13: P1.9
/RESET: P1.26
/SCL: P1.16
/SDA: P1.15
/SIM_CLK: R4.1, SIM1.3, U2.3
/SIM_DATA: R5.1, SIM1.6, U2.4
/SIM_RST: R6.1, SIM1.2, U2.5
/VBAT: C3.1, C4.1, C5.1, C6.1, C7.1, L1.2, P2.1, R3.1
/VSIM: C8.1, P2.6, SIM1.1, U2.6
GND: C1.2, C2.2, C3.2, C4.2, C5.2, C6.2, C7.2, C8.2, P1.27, R1.2, SIM1.4, U1.2 (GND), U2.2
unnamed: L1.1, U1.3 (SW)
unnamed: P2.3, R4.2
unnamed: P2.4, R5.2
unnamed: P2.5, R6.2
unnamed: R1.1, R2.2, U1.5 (FB)
unnamed: R2.1, R3.2

Notes on the sheet:
UPIN 27
DigitEco s.r.l.
VBAT = 4,02 volt
VSIM = 1,8 volt

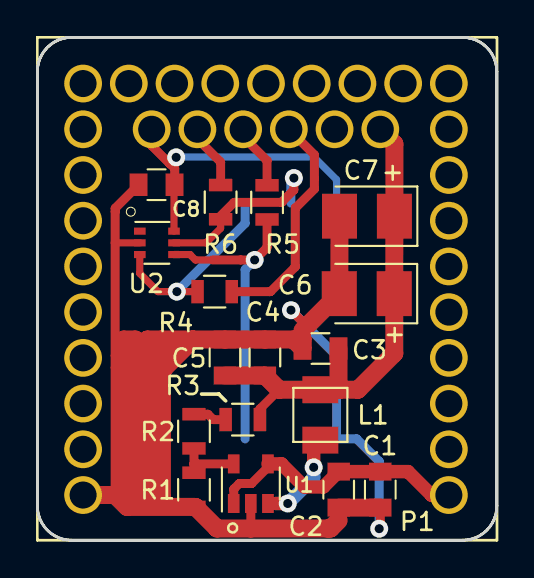
[picture p20: board Microduino_SIM_shield_DE.kicad_pcb from above]

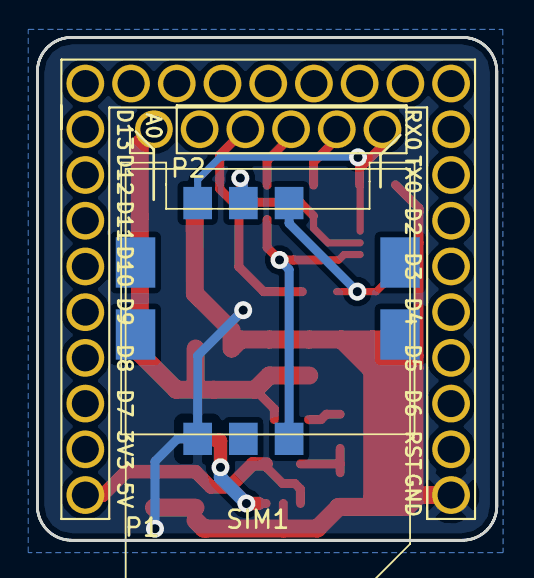
[picture p21: board Microduino_SIM_shield_DE.kicad_pcb from below]

Board: 2 copper layers, 25.5 x 27.9 mm, 20 parts (3 on the bottom side), 13 nets.
