moris626/rmap/kicad/stima_v3/Microduino_GSM_DE/SIM800C_DE/Microduino_SIM800C_DE.kicad_pcb

## KiCad design kicad/stima_v3/Microduino_GSM_DE/SIM800C_DE/Microduino_SIM800C_DE.kicad_pcb (2018-06-27)

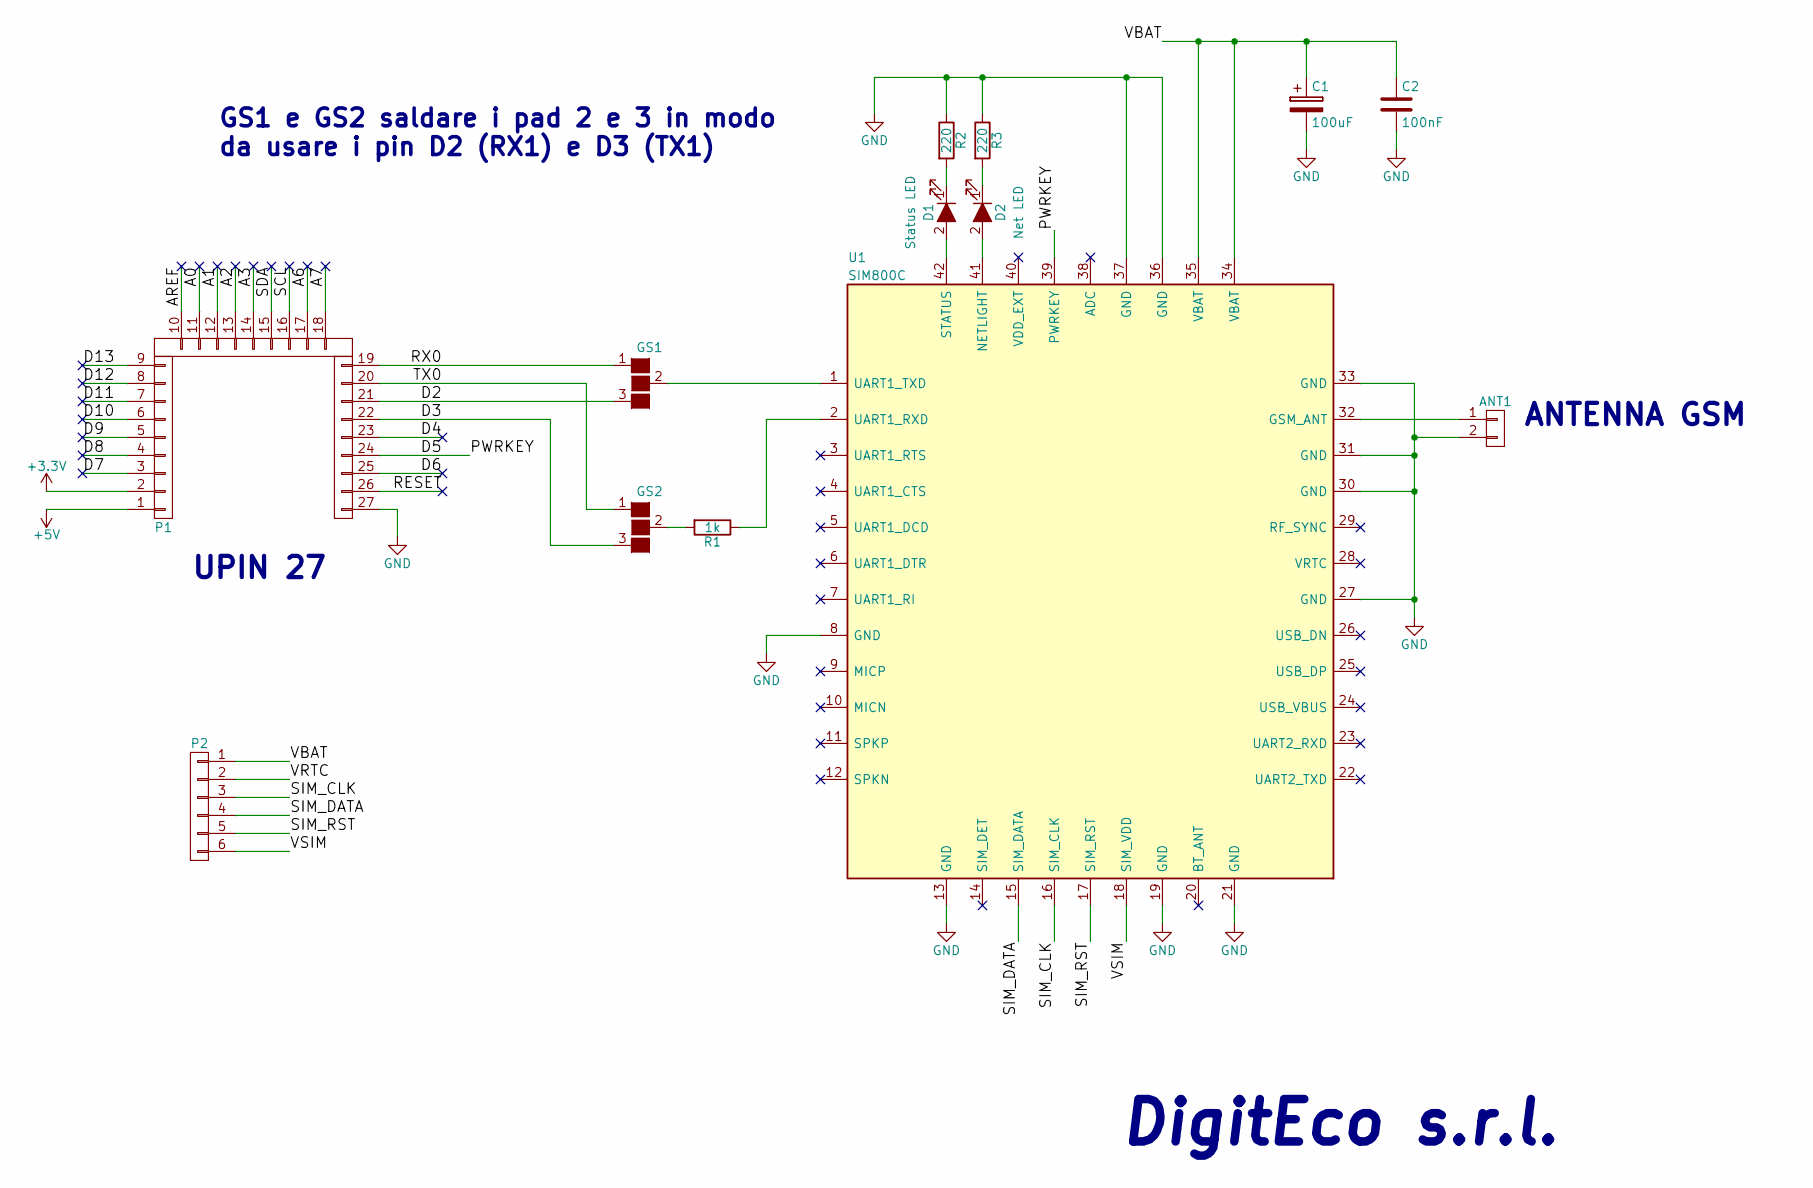
[picture p22: schematic Microduino_SIM800C_DE.sch, Microduino SIM800C DE]

Parts:
ANT1: CONN_01X02; Molex_SMA_Jack_Edge_Mount_microduino
C1: 100uF; CP_Tantalum_Case-B_EIA-3528-21_Reflow
C2: 100nF; C_0805
D1, D2: LED_ALT; LED_0805
GS1, GS2: GS3
P1: CONN_1x27; Upin_27
P2: CONN_01X06; Pin_Header_Straight_1x06_Pitch2.54mm
R1: 1k; R_0805
R2, R3: 220; R_0805
U1: SIM800C; SIM800C-42PIN

Connections:
+3V3: P1.2
+5V: P1.1
/A0: P1.11
/A1: P1.12
/A2: P1.13
/A3: P1.14
/A6: P1.17
/A7: P1.18
/AREF: P1.10
/D2: GS1.3 (G3), P1.21
/D3: GS2.3 (G3), P1.22
/D4: P1.23
/D5: P1.24, U1.39 (PWRKEY)
/D6: P1.25
/D7: P1.3
/D8: P1.4
/D9: P1.5
/D10: P1.6
/D11: P1.7
/D12: P1.8
/D13: P1.9
/RESET: P1.26
/RX0: GS1.1 (G1), P1.19
/SCL: P1.16
/SDA: P1.15
/SIM_CLK: P2.3, U1.16 (SIM_CLK)
/SIM_DATA: P2.4, U1.15 (SIM_DATA)
/SIM_RST: P2.5, U1.17 (SIM_RST)
/TX0: GS2.1 (G1), P1.20
/VBAT: C1.1, C2.1, P2.1, U1.34 (VBAT), U1.35 (VBAT)
/VRTC: P2.2
/VSIM: P2.6, U1.18 (SIM_VDD)
GND: ANT1.2, C1.2, C2.2, P1.27, R2.1, R3.1, U1.8 (GND), U1.13 (GND), U1.19 (GND), U1.21 (GND), U1.27 (GND), U1.30 (GND), U1.31 (GND), U1.33 (GND), U1.36 (GND), U1.37 (GND)
unnamed: ANT1.1, U1.32 (GSM_ANT)
unnamed: D1.1 (K), R2.2
unnamed: D1.2 (A), U1.42 (STATUS)
unnamed: D2.1 (K), R3.2
unnamed: D2.2 (A), U1.41 (NETLIGHT)
unnamed: GS1.2 (G2), U1.1 (UART1_TXD)
unnamed: GS2.2 (G2), R1.2
unnamed: R1.1, U1.2 (UART1_RXD)

Notes on the sheet:
UPIN 27
DigitEco s.r.l.
ANTENNA GSM
GS1 e GS2 saldare i pad 2 e 3 in modo da usare i pin D2 (RX1) e D3 (TX1)

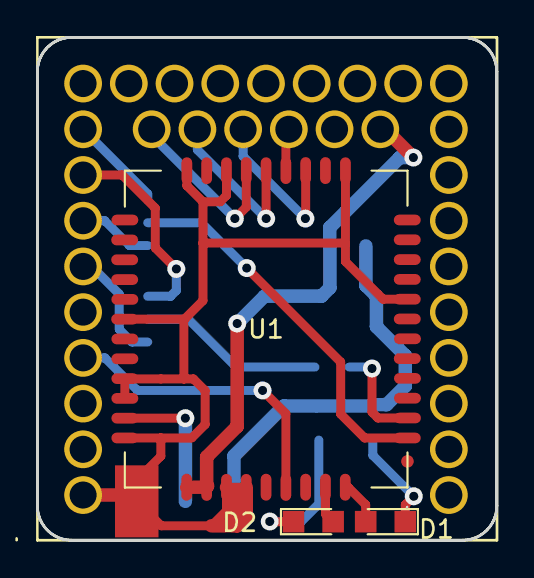
[picture p23: board Microduino_SIM800C_DE.kicad_pcb from above]

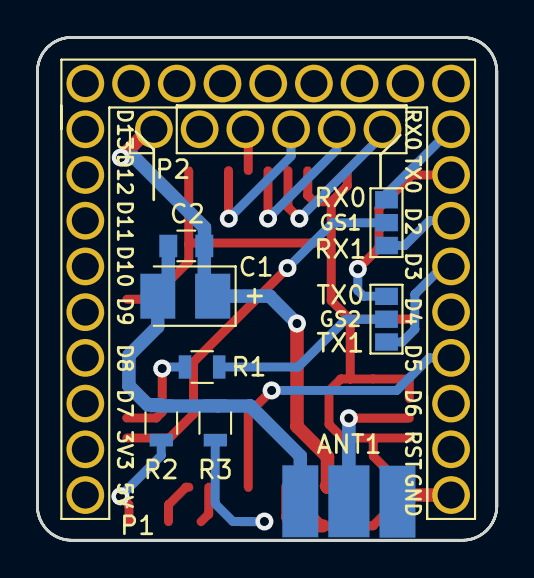
[picture p24: board Microduino_SIM800C_DE.kicad_pcb from below]

Board: 2 copper layers, 25.5 x 27.9 mm, 13 parts (10 on the bottom side), 19 nets.
