moris626/rmap/kicad/stima_v3/Microduino_RTC_DE/Microduino_RTC_DE.kicad_pcb

## KiCad design kicad/stima_v3/Microduino_RTC_DE/Microduino_RTC_DE.kicad_pcb (2018-06-27)

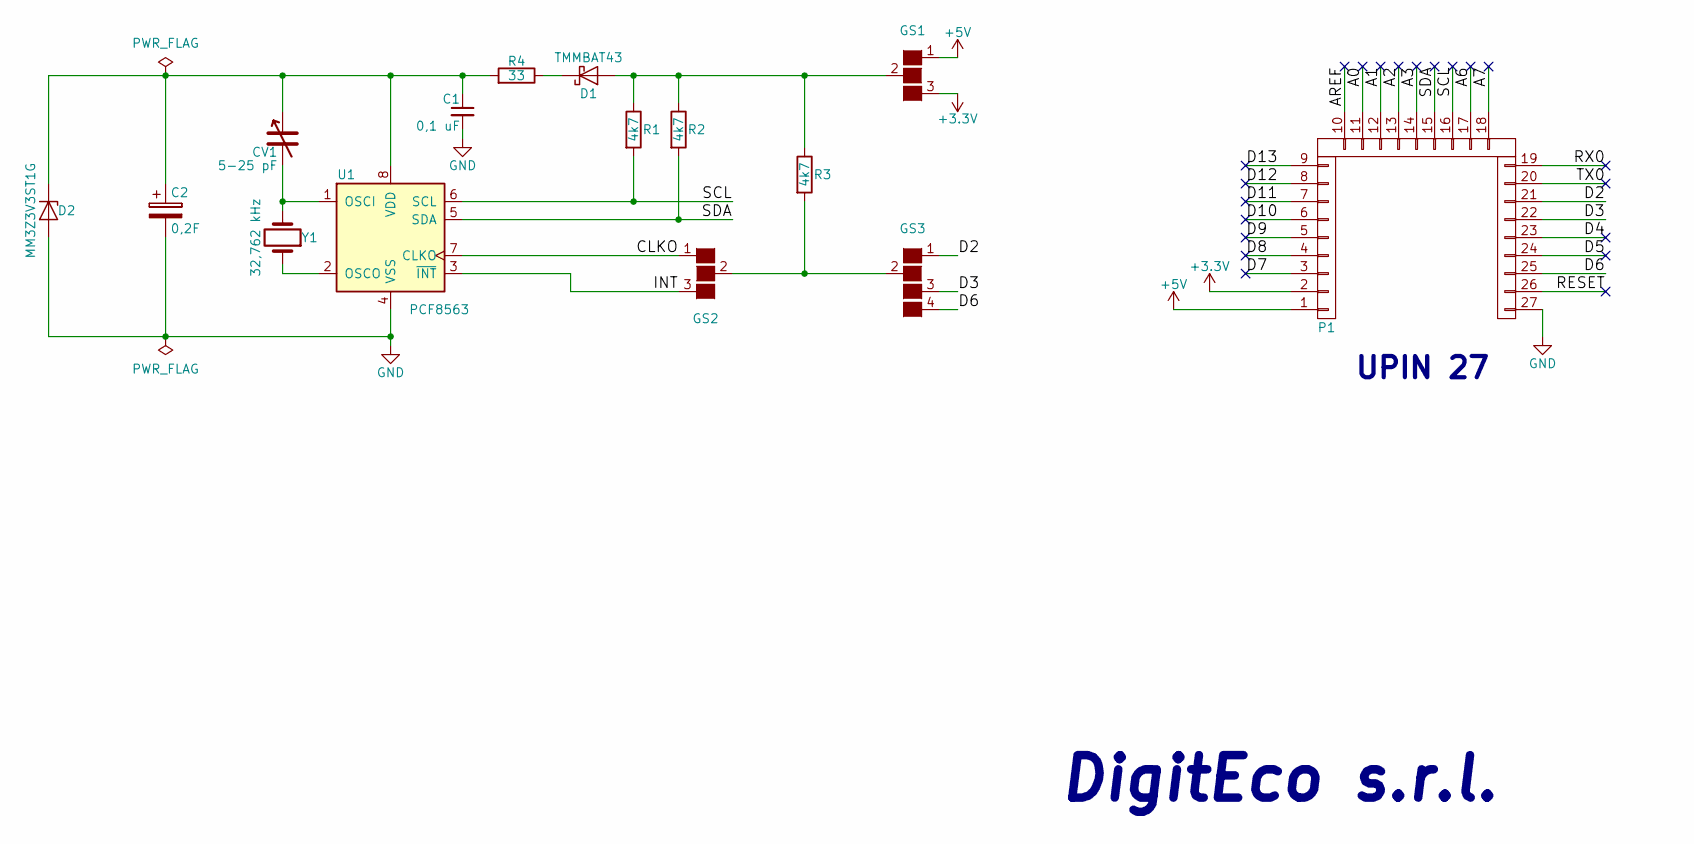
[picture p25: schematic Microduino_RTC_DE.sch, Microduino RTC DE]

Parts:
C1: 0,1 uF; C_0805
C2: 0,2F; Supercap
CV1: 5-25 pF; C_1206
D1: TMMBAT43; D_MiniMELF_Standard
D2: MM3Z3V3ST1G; D_SOD-323
GS1, GS2: GS3
GS3: GS4
P1: CONN_1x27; Upin_27
R1, R2, R3: 4k7; R_0805
R4: 33; R_0805
U1: PCF8563; SOIC-8_3.9x4.9mm_Pitch1.27mm
Y1: 32,762 kHz; Crystal_SMD_G8-2pin_3.2x1.5mm_HandSoldering

Connections:
+3V3: GS1.3 (G3), P1.2
+5V: GS1.1 (G1), P1.1
/A0: P1.11
/A1: P1.12
/A2: P1.13
/A3: P1.14
/A6: P1.17
/A7: P1.18
/AREF: P1.10
/CLKO: GS2.1 (G1), U1.7 (CLKO); also elsewhere on the board
/D2: GS3.1 (G1), P1.21
/D3: GS3.3 (G3), P1.22
/D4: P1.23
/D5: P1.24
/D6: GS3.4 (G4), P1.25
/D7: P1.3
/D8: P1.4
/D9: P1.5
/D10: P1.6
/D11: P1.7
/D12: P1.8
/D13: P1.9
/INT: GS2.3 (G3), U1.3 (~INT~); also elsewhere on the board
/RESET: P1.26
/RX0: P1.19
/SCL: P1.16, R1.2, U1.6 (SCL)
/SDA: P1.15, R2.2, U1.5 (SDA)
/TX0: P1.20
GND: C1.2, C2.2, D2.2 (A), P1.27, U1.4 (VSS)
unnamed: C1.1, C2.1, CV1.1, D2.1 (K), R4.2, U1.8 (VDD)
unnamed: CV1.2, U1.1 (OSCI), Y1.2
unnamed: D1.1 (K), R4.1
unnamed: D1.2 (A), GS1.2 (G2), R1.1, R2.1, R3.1
unnamed 33: GS2.2 (G2), GS3.2 (G2), R3.2; also elsewhere on the board
unnamed: U1.2 (OSCO), Y1.1

Notes on the sheet:
UPIN 27
DigitEco s.r.l.

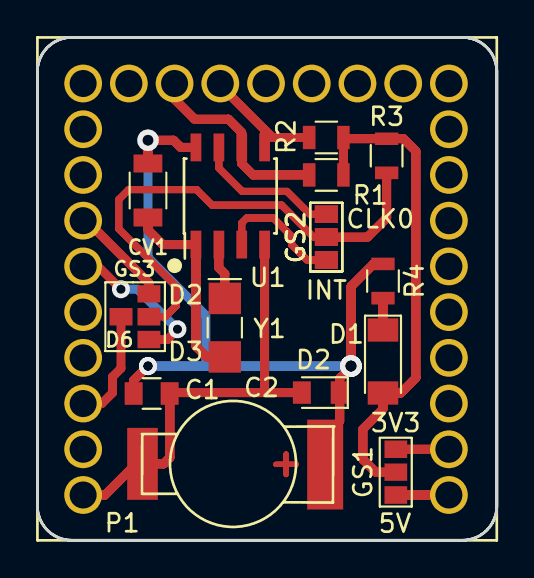
[picture p26: board Microduino_RTC_DE.kicad_pcb from above]

Board: 2 copper layers, 25.5 x 27.9 mm, 16 parts (1 on the bottom side), 16 nets.

Other parts of the board:
GS2#2: GS3

Their connections:
/CLKO: GS2#2.1; also elsewhere on the board
/INT: GS2#2.3; also elsewhere on the board
unnamed 33: GS2#2.2; also elsewhere on the board
