moris626/rmap/kicad/stima_v3/Microduino_BASE_DE/Microduino_Base_DE.kicad_pcb

## KiCad design kicad/stima_v3/Microduino_BASE_DE/Microduino_Base_DE.kicad_pcb (2018-06-27)

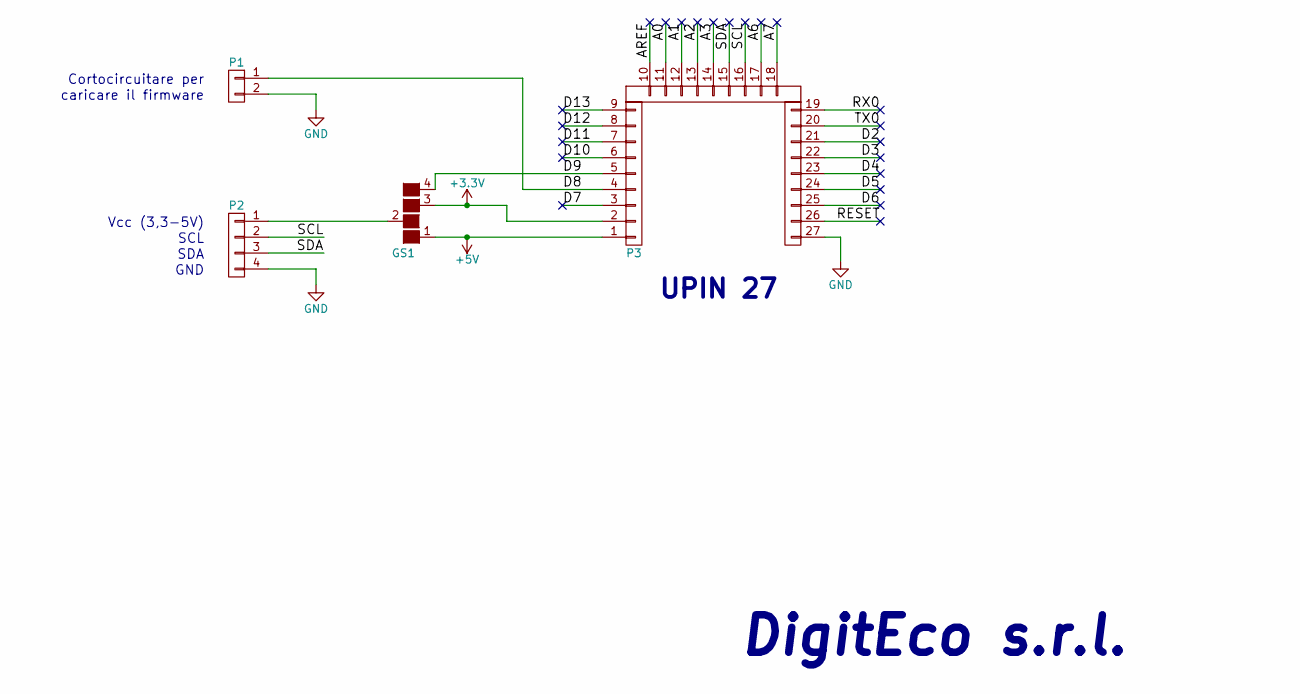
[picture p27: schematic Microduino_Base_DE.sch, Microduino Base DE]

Parts:
GS1: GS4
P1: CONN_01X02; Pin_Header_Angled_1x02_Pitch2.54mm
P2: CONN_01X04; WHURT_4pin_90°_61900411021
P3: CONN_1x27; Upin_27

Connections:
+3V3: GS1.3 (G3), P3.2
+5V: GS1.1 (G1), P3.1
/A0: P3.11
/A1: P3.12
/A2: P3.13
/A3: P3.14
/A6: P3.17
/A7: P3.18
/AREF: P3.10
/D2: P3.21
/D3: P3.22
/D4: P3.23
/D5: P3.24
/D6: P3.25
/D7: P3.3
/D8: P1.1, P3.4
/D9: GS1.4 (G4), P3.5
/D10: P3.6
/D11: P3.7
/D12: P3.8
/D13: P3.9
/RESET: P3.26
/RX0: P3.19
/SCL: P2.2, P3.16
/SDA: P2.3, P3.15
/TX0: P3.20
GND: P1.2, P2.4, P3.27
unnamed: GS1.2 (G2), P2.1

Notes on the sheet:
UPIN 27
DigitEco s.r.l.
GND
SDA
SCL
Vcc (3,3-5V)
Cortocircuitare per
caricare il firmware

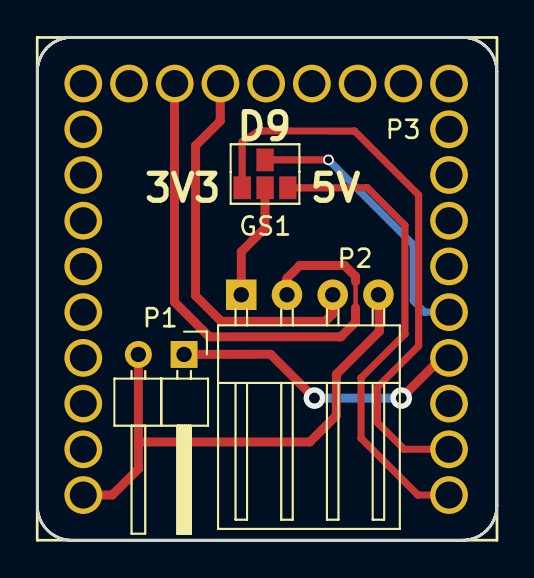
[picture p28: board Microduino_Base_DE.kicad_pcb from above]

Board: 2 copper layers, 25.5 x 27.9 mm, 4 parts (1 on the bottom side), 8 nets.
