moris626/rmap/arduino/sketchbook/hardware/Microduino/avr/bootloaders/digitecoboot/pin_defs.h

/*
 * pin_defs.h
 * optiboot helper defining the default pin assignments (LED, SOFT_UART)
 * for the various chips that are supported.  This also has some ugly macros
 * for selecting among various UARTs and LED possibilities using command-line
 * defines like "UART=2 LED=B5"
 *
 * Copyright 2013-2015 by Bill Westfield.
 * Copyright 2010 by Peter Knight.
 * This software is licensed under version 2 of the Gnu Public Licence.
 * See optiboot.c for details.
 */

/*------------------------------------------------------------------------ */
#if defined(__AVR_ATmega168__) || defined(__AVR_ATmega168P__) || defined(__AVR_ATmega328__) || defined(__AVR_ATmega328P__) || defined(__AVR_ATmega88) || defined(__AVR_ATmega8__) || defined(__AVR_ATmega88__)
/*------------------------------------------------------------------------ */

/* Onboard LED is connected to pin PB5 in Arduino NG, Diecimila, and Duemilanove
 */
#if !defined(LED)
#define LED B5
#endif

/* Ports for soft UART */
#ifdef SOFT_UART
#define UART_PORT   PORTD
#define UART_PIN    PIND
#define UART_DDR    DDRD
#define UART_TX_BIT 1
#define UART_RX_BIT 0
#endif
#endif

/*
 * Handle devices with up to 4 uarts (eg m1280.)  Rather inelegantly.
 * Note that mega8/m32 still needs special handling, because ubrr is handled
 * differently.
 */
#if UART == 0
# define UART_SRA UCSR0A
# define UART_SRB UCSR0B
# define UART_SRC UCSR0C
# define UART_SRL UBRR0L
# define UART_UDR UDR0
#elif UART == 1
#if !defined(UDR1)
#error UART == 1, but no UART1 on device
#endif
# define UART_SRA UCSR1A
# define UART_SRB UCSR1B
# define UART_SRC UCSR1C
# define UART_SRL UBRR1L
# define UART_UDR UDR1
#elif UART == 2
#if !defined(UDR2)
#error UART == 2, but no UART2 on device
#endif
# define UART_SRA UCSR2A
# define UART_SRB UCSR2B
# define UART_SRC UCSR2C
# define UART_SRL UBRR2L
# define UART_UDR UDR2
#elif UART == 3
#if !defined(UDR3)
#error UART == 3, but no UART3 on device
#endif
# define UART_SRA UCSR3A
# define UART_SRB UCSR3B
# define UART_SRC UCSR3C
# define UART_SRL UBRR3L
# define UART_UDR UDR3
#endif

#if defined(__AVR_ATmega8__) || defined (__AVR_ATmega32__) || defined (__AVR_ATmega16__)
  //Name conversion R.Wiersma
  #define UCSR0A	UCSRA
  #define UDR0 		UDR
  #define UDRE0 	UDRE
  #define RXC0		RXC
  #define FE0           FE
  #define TIFR1 	TIFR
  #define WDTCSR	WDTCR
#endif
#if defined (__AVR_ATmega32__) || defined (__AVR_ATmega16__)
  #define WDCE		WDTOE
#endif

/* Luminet support */
/*------------------------------------------------------------------------ */
#if defined(__AVR_ATtiny84__)
/*------------------------------------------------------------------------ */
/* Red LED is connected to pin PA4 */
#if !defined(LED)
#define LED         A4
#endif

/* Ports for soft UART - left port only for now. TX/RX on PA2/PA3 */
#ifdef SOFT_UART
#define UART_PORT   PORTA
#define UART_PIN    PINA
#define UART_DDR    DDRA
#define UART_TX_BIT 2
#define UART_RX_BIT 3
#endif
#endif

/*------------------------------------------------------------------------ */
/* Sanguino support (and other 40pin DIP cpus) */
#if defined(__AVR_ATmega644P__) || defined(__AVR_ATmega1284P__) || defined(__AVR_ATmega32__) || defined (__AVR_ATmega16__)
/*------------------------------------------------------------------------ */
/* Onboard LED is connected to pin PB0 on Sanguino */
#if !defined(LED)
#define LED         B0
#endif

/* Ports for soft UART */
#ifdef SOFT_UART
#define UART_PORT   PORTD
#define UART_PIN    PIND
#define UART_DDR    DDRD
#define UART_TX_BIT 1
#define UART_RX_BIT 0
#endif
#endif

/*------------------------------------------------------------------------ */
/* Mega support */
#if defined(__AVR_ATmega1280__)
/*------------------------------------------------------------------------ */
/* Onboard LED is connected to pin PB7 on Arduino Mega */
#if !defined(LED)
#define LED         B7
#endif

/* Ports for soft UART */
#ifdef SOFT_UART
#define UART_PORT   PORTE
#define UART_PIN    PINE
#define UART_DDR    DDRE
#define UART_TX_BIT 1
#define UART_RX_BIT 0
#endif
#endif

/*
 * ------------------------------------------------------------------------
 * A bunch of macros to enable the LED to be specifed as "B5" for bit 5
 * of port B, and similar.
 */

#define A0 0x100
#define A1 0x101
#define A2 0x102
#define A3 0x103
#define A4 0x104
#define A5 0x105
#define A6 0x106
#define A7 0x107

#define B0 0x200
#define B1 0x201
#define B2 0x202
#define B3 0x203
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
#elif LED == A7
#undef LED
#define LED_DDR     DDRA
#define LED_PORT    PORTA
#define LED_PIN     PINA
#define LED	    PINA7

#else
#error -------------------------------------------
#error Unrecognized LED name.  Should be like "B5"
#error -------------------------------------------
#endif
