moris626/rmap/arduino/sketchbook/stima_v2/i2c-sdsmics/i2c-sdsmics.ino

/**********************************************************************
Copyright (C) 2017  Paolo Paruno <p.patruno@iperbole.bologna.it>
authors:
Paolo Paruno <p.patruno@iperbole.bologna.it>

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
You should have received a copy of the GNU General Public License
along with this program.  If not, see <http://www.gnu.org/licenses/>.
**********************************************************************/

/*********************************************************************
 *
 * This program implements elaboration of sds011 inovafitness sensor
 * for pm2.5 and pm 10 exported to i2c interface.
 * 

elaborazioni:

a) eseguo 3 misure di fila (1 al secondo per 3 secondi) e butto via il
minimo e il massimo e tengo il valore "centrale" (internal to Sds011 library)

b) ogni 6 secondi memorizzo questo valore

c) ogni 60 secondi faccio media minimo massimo e deviazione standard

d) ogni 60 secondi si elaborano i valori orari della media, minimo,
massimo e deviazione standard dai valori sul periodo di 60 sec, ma che
equivale a farlo sui dati a) 

il sensore ha due modalità di funzionamento:

1) oneshot; dico fai una miura e mi vengono dati i dati a) (poi farò
conti come e quando voglio) posso fare una misura ogni 3 secondi circa

2)continuo: mi vengono forniti a richiesta i valori b) e d)

**********************************************************************/
/*
buffer scrivibili da i2c
viene scritto buffer1 e buffer2
viene letto buffer2
i puntatori a buffer1 e buffer2 vengono scambiati in una operazione atomica all'inizio del main loop
*/

/*
buffer leggibili da i2c
le elaborazioni scrivono sempre su buffer1
viene sempre letto buffer2
i puntatori a buffer1 e buffer2 vengono scambiati in una operazione atomica al comando stop
*/

#define VERSION 04             //Software version for cross checking

#include <limits.h>
#include <avr/wdt.h>
#include "Wire.h"
#include "registers-sdsmics.h"         //Register definitions
#include "config.h"
#include "IntBuffer.h"
#include "FloatBuffer.h"

#ifdef SDS011PRESENT
#include "Sds011.h"
#endif
#ifdef MICS4514PRESENT
#include "Mics4514.h"
#endif

#include "EEPROMAnything.h"
#include "Calibration.h"
#include <ArduinoLog.h>

// logging level at compile time
// Available levels are:
// LOG_LEVEL_SILENT, LOG_LEVEL_FATAL, LOG_LEVEL_ERROR, LOG_LEVEL_WARNING, LOG_LEVEL_NOTICE, LOG_LEVEL_VERBOSE
#define LOG_LEVEL   LOG_LEVEL_NOTICE

#define REG_MAP_SIZE            sizeof(I2C_REGISTERS)       //size of register map
#define REG_PM_SIZE           sizeof(pm_t)                  //size of register map for pm
#define REG_CONO2_SIZE           sizeof(cono2_t)                  //size of register map for cono2
#define REG_WRITABLE_MAP_SIZE   sizeof(I2C_WRITABLE_REGISTERS)       //size of register map

#define MAX_SENT_BYTES     0x0F                      //maximum amount of data that I could receive from a master device (register, plus 15 byte)

char confver[9] = CONFVER; // version of configuration saved on eeprom

#ifdef SDS011PRESENT
sds011::Sds011 sensor(SERIALSDS011);
#endif
#ifdef MICS4514PRESENT
mics4514::Mics4514 sensormics(COPIN,NO2PIN,HEATERPIN,SCALE1PIN,SCALE2PIN);

// NO2 Sensor calibration
calibration::Calibration NO2Cal;

// CO Sensor calibration
calibration::Calibration COCal;

// PM2 Sensor calibration
calibration::Calibration PM25Cal;

// PM10 Sensor calibration
calibration::Calibration PM10Cal;

#endif

#ifdef SDS011PRESENT
IntBuffer cbpm2560n;
IntBuffer cbpm1060n;
IntBuffer cbpm2560m;
IntBuffer cbpm1060m;
IntBuffer cbpm2560x;
IntBuffer cbpm1060x;
FloatBuffer cbsum2pm25;
FloatBuffer cbsum2pm10;
FloatBuffer cbsumpm25;
FloatBuffer cbsumpm10;
#endif

#ifdef MICS4514PRESENT
IntBuffer cbco60n;
IntBuffer cbno260n;
IntBuffer cbco60m;
IntBuffer cbno260m;
IntBuffer cbco60x;
IntBuffer cbno260x;
FloatBuffer cbsum2co;
FloatBuffer cbsumco;
FloatBuffer cbsum2no2;
FloatBuffer cbsumno2;
#endif

typedef struct {
  uint8_t    sw_version;                          // Version of the I2C_SDS011 sw
} status_t;

typedef struct {
  uint16_t     pm25;
  uint16_t     pm10;
  uint16_t     minpm25;
  uint16_t     minpm10;
  uint16_t     meanpm25;
  uint16_t     meanpm10;
  uint16_t     maxpm25;
  uint16_t     maxpm10;
  uint16_t     sigmapm25;
  uint16_t     sigmapm10;
  uint16_t     pm25sample;
  uint16_t     pm10sample;
} pm_t;

typedef struct {
  uint16_t     co;
  uint16_t     no2;
  uint16_t     minco;
  uint16_t     minno2;
  uint16_t     meanco;
  uint16_t     meanno2;
  uint16_t     maxco;
  uint16_t     maxno2;
  uint16_t     sigmaco;
  uint16_t     sigmano2;
  uint16_t     coresistance;
  uint16_t     no2resistance;
} cono2_t;

typedef struct {

//Status registers
  status_t     status;                   // 0x00  status register

//data
  pm_t                pm;                     // 0x01 pm
  cono2_t             cono2;                  // 0x15 pm
} I2C_REGISTERS;


typedef struct {

  //sample mode
  bool                  oneshot;                  // one shot active
  uint8_t               i2c_address;              // i2c bus address (short unsigned int)

#ifdef MICS4514PRESENT
  // calibration data
  // Define the number of calibration points
  uint8_t no2numPoints;
  // Concentratios used in calibration process
  float no2concentrations[MAX_POINTS];
  // Calibration resistances obtained during calibration process
  float no2resistences[MAX_POINTS];
  
  // Define the number of calibration points
  uint8_t conumPoints;
  // Concentrations used in calibration process
  float coconcentrations[MAX_POINTS];
  // Calibration resistences obtained during calibration process (in KOHMs)
  float coresistences[MAX_POINTS];
#endif

#ifdef SDS011PRESENT
  // calibration data
  // Define the number of calibration points
  uint8_t pm25numPoints;
  // Concentratios used in calibration process
  float pm25concentrations[MAX_POINTS];
  // Calibration samples obtained during calibration process
  float pm25samples[MAX_POINTS];
  
  // Define the number of calibration points
  uint8_t pm10numPoints;
  // Concentrations used in calibration process
  float pm10concentrations[MAX_POINTS];
  // Calibration samples obtained during calibration process
  float pm10samples[MAX_POINTS];
#endif



  
  void save (int* p) volatile {                            // save to eeprom

    IF_SDEBUG(Serial.print(F("oneshot: "))); IF_SDEBUG(Serial.println(oneshot));
    IF_SDEBUG(Serial.print(F("i2c address: "))); IF_SDEBUG(Serial.println(i2c_address));

    *p+=EEPROM_writeAnything(*p, oneshot);
    *p+=EEPROM_writeAnything(*p, i2c_address);
#ifdef MICS4514PRESENT
    *p+=EEPROM_writeAnything(*p, no2numPoints);    
    *p+=EEPROM_writeAnything(*p, no2concentrations);
    *p+=EEPROM_writeAnything(*p, no2resistences);
    *p+=EEPROM_writeAnything(*p, conumPoints);
    *p+=EEPROM_writeAnything(*p, coconcentrations);
    *p+=EEPROM_writeAnything(*p, coresistences);
#endif
#ifdef SDS011PRESENT
    *p+=EEPROM_writeAnything(*p, pm25numPoints);    
    *p+=EEPROM_writeAnything(*p, pm25concentrations);
    *p+=EEPROM_writeAnything(*p, pm25samples);
    *p+=EEPROM_writeAnything(*p, pm10numPoints);
    *p+=EEPROM_writeAnything(*p, pm10concentrations);
    *p+=EEPROM_writeAnything(*p, pm10samples);
#endif

  }
  
  void load (int* p) volatile {                            // load from eeprom
    *p+=EEPROM_readAnything(*p, oneshot);
    *p+=EEPROM_readAnything(*p, i2c_address);
#ifdef MICS4514PRESENT
    *p+=EEPROM_readAnything(*p, no2numPoints);
    *p+=EEPROM_readAnything(*p, no2concentrations);
    *p+=EEPROM_readAnything(*p, no2resistences);
    *p+=EEPROM_readAnything(*p, conumPoints);
    *p+=EEPROM_readAnything(*p, coconcentrations);
    *p+=EEPROM_readAnything(*p, coresistences);
#endif
#ifdef SDS011PRESENT
    *p+=EEPROM_readAnything(*p, pm25numPoints);    
    *p+=EEPROM_readAnything(*p, pm25concentrations);
    *p+=EEPROM_readAnything(*p, pm25samples);
    *p+=EEPROM_readAnything(*p, pm10numPoints);
    *p+=EEPROM_readAnything(*p, pm10concentrations);
    *p+=EEPROM_readAnything(*p, pm10samples);
#endif
  }
} I2C_WRITABLE_REGISTERS;


volatile static I2C_REGISTERS    i2c_buffer1;
volatile static I2C_REGISTERS    i2c_buffer2;

volatile static I2C_REGISTERS* i2c_dataset1;
volatile static I2C_REGISTERS* i2c_dataset2;
volatile static I2C_REGISTERS* i2c_datasettmp;

volatile static I2C_WRITABLE_REGISTERS  i2c_writablebuffer1;
volatile static I2C_WRITABLE_REGISTERS  i2c_writablebuffer2;

volatile static I2C_WRITABLE_REGISTERS* i2c_writabledataset1;
volatile static I2C_WRITABLE_REGISTERS* i2c_writabledataset2;
volatile static I2C_WRITABLE_REGISTERS* i2c_writabledatasettmp;

volatile static uint8_t         receivedCommands[MAX_SENT_BYTES];
volatile static uint8_t         new_command;                        //new command received (!=0)

#ifdef SDS011PRESENT
float meanpm25;
float meanpm10;
long int minpm25;
long int minpm10;
long int maxpm25;
long int maxpm10;
float sum2pm25;
float sumpm25;
float sum2pm10;
float sumpm10;
#endif

#ifdef MICS4514PRESENT
float meanco;
float meanno2;
long int minco;
long int minno2;
long int maxco;
long int maxno2;
float sum2co;
float sumco;
float sum2no2;
float sumno2;
#endif

uint8_t nsample1;

// one shot management
static bool oneshot;
static bool start=false;
static bool stop=false;

volatile unsigned int count;

unsigned long starttime;
boolean forcedefault=false;

//////////////////////////////////////////////////////////////////////////////////////
// I2C handlers
// Handler for requesting data
//
void requestEvent()
{
  Wire.write(((uint8_t *)i2c_dataset2)+receivedCommands[0],32);
  //Write up to 32 byte, since master is responsible for reading and sending NACK
  //32 byte limit is in the Wire library, we have to live with it unless writing our own wire library

  //Serial.print("receivedCommands: ");
  //Serial.println(receivedCommands[0]);
  //Serial.println(*((uint8_t *)(i2c_dataset2)+receivedCommands[0]));
  //Serial.println(*((uint8_t *)(i2c_dataset2)+receivedCommands[0]+1));
  //Serial.println(*((uint8_t *)(i2c_dataset2)+receivedCommands[0]+2));
  //Serial.println(*((uint8_t *)(i2c_dataset2)+receivedCommands[0]+3));
}

//Handler for receiving data
void receiveEvent( int bytesReceived)
{
  uint8_t  *ptr1, *ptr2;
     //Serial.print("received:");
     for (int a = 0; a < bytesReceived; a++) {
          if (a < MAX_SENT_BYTES) {
               receivedCommands[a] = Wire.read();
	       //Serial.println(receivedCommands[a]);
          } else {
               Wire.read();  // if we receive more data then allowed just throw it away
          }
     }

 
     if (bytesReceived == 1){
       //read address for a given register
       //Addressing over the reg_map fallback to first byte
       if(bytesReceived == 1 && ( (receivedCommands[0] < 0) || (receivedCommands[0] >= REG_MAP_SIZE))) {
	 receivedCommands[0]=0;
       }
       //IF_SDEBUG(Serial.print("set register:"));IF_SDEBUG(Serial.println(receivedCommands[0]));
       return;
     }


    if (bytesReceived == 2){
       // check for a command
       if (receivedCommands[0] == I2C_SDSMICS_COMMAND) {
	 //IF_SDEBUG(Serial.print("received command:"));IF_SDEBUG(Serial.println(receivedCommands[1]));
	 //if (new_command != 0) IF_SDEBUG(Serial.print("command overflow !"));
	 new_command = receivedCommands[1]; return; }
     }


     //More than 1 byte was received, so there is definitely some data to write into a register
     //Check for writeable registers and discard data is it's not writeable

     //IF_SDEBUG(Serial.println("data for write: "));
     //IF_SDEBUG(Serial.println(receivedCommands[0]));
     //IF_SDEBUG(Serial.println(receivedCommands[1]));
     
     if ((receivedCommands[0]>=I2C_SDSMICS_MAP_WRITABLE) && (receivedCommands[0] < (I2C_SDSMICS_MAP_WRITABLE+REG_WRITABLE_MAP_SIZE))) {    
       if ((receivedCommands[0]+(unsigned int)(bytesReceived-1)) <= (I2C_SDSMICS_MAP_WRITABLE+REG_WRITABLE_MAP_SIZE)) {
	 //Writeable registers
	 // the two buffer should be in sync
	 //ptr1 = (uint8_t *)i2c_writabledataset1+receivedCommands[0]-I2C_SDSMICS_MAP_WRITABLE;
	 ptr2 = (uint8_t *)i2c_writabledataset2+receivedCommands[0]-I2C_SDSMICS_MAP_WRITABLE;
	 for (int a = 1; a < bytesReceived; a++) { 
	   //IF_SDEBUG(Serial.print("write in writable buffer:"));IF_SDEBUG(Serial.println(a));IF_SDEBUG(Serial.println(receivedCommands[a]));
	   //*ptr1++ = receivedCommands[a];
	   *ptr2++ = receivedCommands[a];
	 }
	 // new data written
       }
    }
}

/////////////////////////////////////////////////////////////////////////////////////////////////////////


void setup() {

  uint8_t i;

  /*
  Nel caso di un chip in standalone senza bootloader, la prima
  istruzione che è bene mettere nel setup() è sempre la disattivazione
  del Watchdog stesso: il Watchdog, infatti, resta attivo dopo il
  reset e, se non disabilitato, esso può provare il reset perpetuo del
  microcontrollore
  */
  wdt_disable();

  // enable watchdog with timeout to 8s
  wdt_enable(WDTO_8S);

  IF_SDEBUG(Serial.begin(115200));        // connect to the serial port
  // Pass log level, whether to show log level, and print interface.
  // Available levels are:
  // LOG_LEVEL_SILENT, LOG_LEVEL_FATAL, LOG_LEVEL_ERROR, LOG_LEVEL_WARNING, LOG_LEVEL_NOTICE, LOG_LEVEL_VERBOSE
  // Note: if you want to fully remove all logging code, change #define LOG_LEVEL ....
  //       this will significantly reduce your project size

  // set runtime log level to the same of compile time
  Log.begin(LOG_LEVEL, &Serial);

  LOGN(F("Start firmware version: %d" CR),VERSION);

  // inizialize double buffer
  i2c_dataset1=&i2c_buffer1;
  i2c_dataset2=&i2c_buffer2;

  // inizialize writable double buffer
  i2c_writabledataset1=&i2c_writablebuffer1;
  i2c_writabledataset2=&i2c_writablebuffer2;

#define SAMPLE1 60000/SAMPLERATE
#define SAMPLE2 60

#ifdef SDS011PRESENT
  meanpm25=0.;
  meanpm10=0.;

  maxpm25=-1;
  maxpm10=-1;

  minpm25=LONG_MAX;
  minpm10=LONG_MAX;

  sum2pm25=0;
  sumpm25=0;

  sum2pm10=0;
  sumpm10=0;
#endif
  
#ifdef MICS4514PRESENT
  meanco=0.;
  meanno2=0.;

  maxco=-1;
  maxno2=-1;

  sum2co=0;
  sumco=0;

  sum2no2=0;
  sumno2=0;

  minco=LONG_MAX;
  minno2=LONG_MAX;
#endif

  nsample1=1;
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
