moris626/rmap/(commit log)

2017-07-03 some improvements and bugfix
    [rmap-config.h, rmap.ino]
2017-07-03 add sketch for test sensor driver library
2017-07-04 Configuration implementation and mqtt path generation. fixed bugs and debug visualization
    [i2c-rain.h, i2c-rain.ino, i2c-th-config.h, i2c-th.h, i2c-th.ino, rmap-config.h, rmap.ino]
2017-07-12 big change: rewrite sensor acquisition tasks end data processing task. SD and MQTT is also implemented with fault detection
2017-07-14 added rtc control with timer and alarm for more control and fix some bugs
    [rmap-config.h, rmap.ino]
2017-07-14 resolved bug due to enabling timer in rtc_task
    [rmap.ino]
2017-08-28 patched wire library for avoid multimaster conflict on i2c bus
2017-08-28 small change in SensorDriver
2017-08-28 add gsm_task for sim800 and bugfixes for ethernet
    [rmap-config.h, rmap.ino]
2017-08-28 bugfixes and small change for i2c-rain
    [i2c-rain-config.h, i2c-rain.h, i2c-rain.ino]
2017-08-28 bugfixes and small change for i2c-th
    [i2c-th-config.h, i2c-th.ino]
