moris626/rmap/(notices)

Notices in the files:
arduino/sketchbook/hardware/Microduino/avr/variants/RF/pins_arduino.h:
Public License along with this library; if not, write to the
Free Software Foundation, Inc., 59 Temple Place, Suite 330,
Boston, MA 02111-1307 USA
arduino/sketchbook/stima/sensor_config/sensor_config.ino:
modify it under the terms of the GNU General Public License as
published by the Free Software Foundation; either version 2 of
the License, or (at your option) any later version.
arduino/sketchbook/domotica/mycamper/mycamper.ino:
This program is free software: you can redistribute it and/or modify
it under the terms of the GNU General Public License as published by
the Free Software Foundation, either version 3 of the License, or
(at your option) any later version.
